Roboparty/roboto_origin/modules/Atom01_hardware/README.md

# Atom01
 Atom01 designed by roboparty
img_v3_02nq_e008615d-36c2-451e-9242-01e79ce202bg
