Roboparty/roboto_origin/modules/atom01_description/Readme.md

This is the URDF file of Atom01, a product of Roboparty.
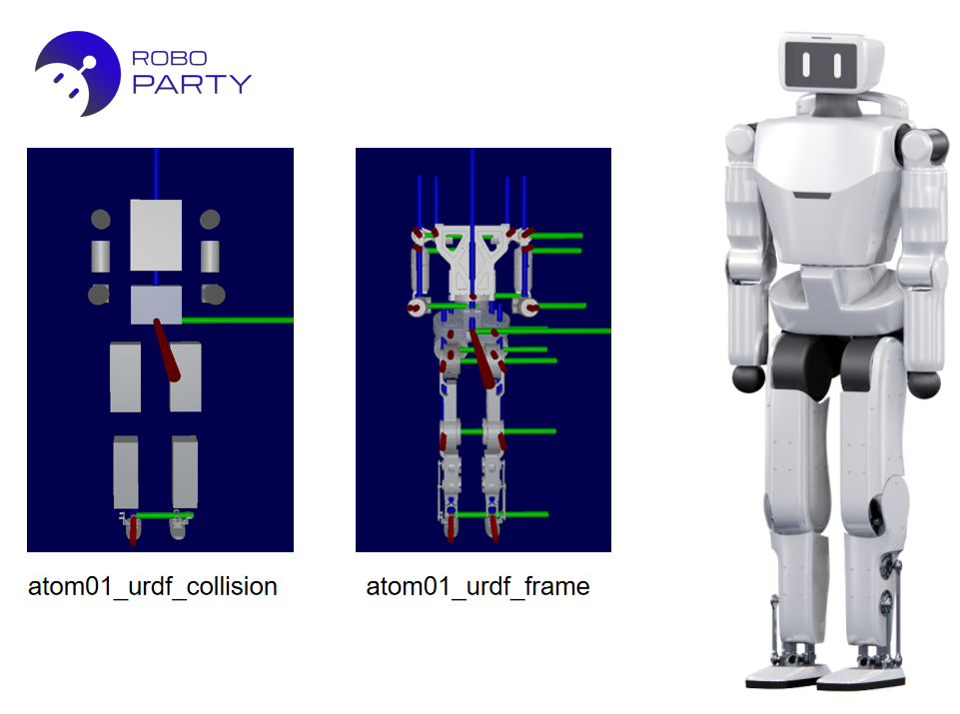
[picture p4: modules/atom01_urdf/atom01_urdf.png]
Atom01 URDF 模型
