Roboparty/roboto_origin/modules/atom01_description/terrain_assets/terrain_hfield.png

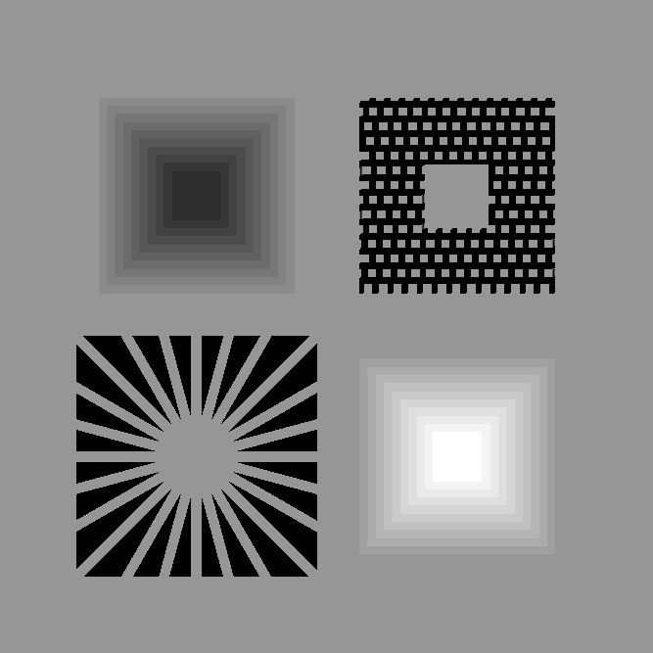
modules/atom01_description/terrain_assets/terrain_hfield.png
