Roboparty/roboto_origin/modules/Atom01_hardware/atom_id.png

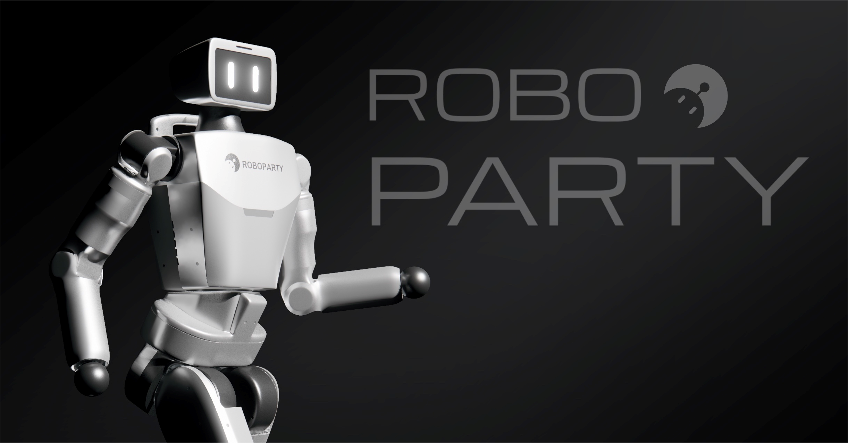
modules/Atom01_hardware/atom_id.png
