Roboparty/roboto_origin/assets/BOM_EN.md

# Internal Roboto D-BOM (English)

**DATE: | 20260105 | Edited by: Taicushier | Signature:**

**Version: | ATOM 01 v1.0.1 | Reviewed by: | Signature:**

**Product Model: | Approved by: | TOTAL:49804CNY | Signature:**

### ATOM 01 Main Frame / Structural Parts
| No. | Part No. | Item | Spec | Category | Unit | Qty | Unit Price (CNY) | Total (CNY) | Notes |
| --- | --- | --- | --- | --- | ---- | --- | --- | --- | --- |
| 1 | ATOM-01-001 | atom arm - copy (1) Atom arm(1) | 120-grit sandblasting / black anodizing | Metal Machining - CNC | pcs  | 4 | 120 | 480 | |
| 2 | ATOM-01-002 | atom arm - copy (2) Atom arm(2) | 120-grit sandblasting / black anodizing | Metal Machining - CNC | pcs  | 4 | 160 | 640 | |
| 3 | ATOM-01-003 | atom arm - copy (3) Atom arm(3) | 120-grit sandblasting / black anodizing | Metal Machining - CNC | pcs  | 4 | 110 | 440 | |
| 4 | ATOM-01-004 | atom arm - copy (4) Atom arm(4) | 120-grit sandblasting / black anodizing | Metal Machining - CNC | pcs  | 4 | 85 | 340 | |
| 5 | ATOM-01-005 | IMU Carrier Board | 120-grit sandblasting / black anodizing | Metal Machining - CNC | pcs  | 1 | 110 | 110 | |
| 6 | ATOM-01-006 | Side Plate Cross Plate | 120-grit sandblasting / black anodizing | Metal Machining - CNC | pcs  | 2 | 85 | 170 | |
| 7 | ATOM-01-007 | Inner Thigh | 120-grit sandblasting / black anodizing | Metal Machining - CNC | pcs  | 2 | 1500 | 3000 | |
| 8 | ATOM-01-008 | Battery Bottom Cover | 120-grit sandblasting / black anodizing | Metal Machining - CNC | pcs  | 1 | 420 | 420 | |
| 9 | ATOM-01-009 | Shoulder | 120-grit sandblasting / black anodizing | Metal Machining - CNC | pcs  | 2 | 160 | 320 | |
| 10  | ATOM-01-010 | Sole of Foot | 120-grit sandblasting / black anodizing | Metal Machining - CNC | pcs  | 2 | 150 | 300 | |
| 11  | ATOM-01-011 | Sole Connecting Rod | 120-grit sandblasting / black anodizing | Metal Machining - CNC | pcs  | 2 | 100 | 200 | |
| 12  | ATOM-01-012 | Ankle Roll Connector | 120-grit sandblasting / black anodizing | Metal Machining - CNC | pcs  | 4 | 35 | 140 | |
| 13  | ATOM-01-013 | Hip Joint Fixation | 120-grit sandblasting / black anodizing | Metal Machining - CNC | pcs  | 1 | 1800 | 1800 | |
| 14  | ATOM-01-014 | Hip Splint | 120-grit sandblasting / black anodizing | Metal Machining - CNC | pcs  | 2 | 350 | 700 | |
| 15  | ATOM-01-015 | Output Flange Connecting Rod | 120-grit sandblasting / black anodizing | Metal Machining - CNC | pcs  | 4 | 45 | 180 | |
| 16  | ATOM-01-016 | Universal Connector | 120-grit sandblasting / black anodizing | Metal Machining - CNC | pcs  | 4 | 360 | 1440 | |
| 17  | ATOM-01-017 | Universal Connector Reamed Flange | 120-grit sandblasting / black anodizing | Metal Machining - CNC | pcs  | 4 | 100 | 400 | |
| 18  | ATOM-01-018 | Lower Leg / Calf | 120-grit sandblasting / black anodizing | Metal Machining - CNC | pcs  | 2 | 1600 | 3200 | |
| 19  | ATOM-01-019 | Chest Rear Splint | 120-grit sandblasting / black anodizing | Metal Machining - CNC | pcs  | 1 | 350 | 350 | |
| 20  | ATOM-01-020 | Chest Front Splint | 120-grit sandblasting / black anodizing | Metal Machining - CNC | pcs  | 1 | 330 | 330 | |
| 21  | ATOM-01-021 | Limit Pin | 120-grit sandblasting / black anodizing | Metal Machining - CNC | pcs  | 8 | 15 | 120 | |
| 22  | ATOM-01-022 | Lower Leg Bearing Lock | 120-grit sandblasting / black anodizing | Metal Machining - CNC | pcs  | 4 | 50 | 200 | |
| 23  | ATOM-01-023 | Waist Support | 120-grit sandblasting / black anodizing | Metal Machining - CNC | pcs  | 1 | 150 | 150 | |
| 24  | ATOM-01-024 | Long Connecting Rod | 120-grit sandblasting / black anodizing | Metal Machining - CNC | pcs  | 2 | 70 | 140 | |
| 25  | ATOM-01-025 | Short Connecting Rod | Sandblasting only | Metal Machining - CNC | pcs  | 2 | 50 | 100 | |
| 26  | ATOM-01-026 | Rubber Sole | | 3D Printed Part | pcs  | 2 | | | |
| | | | | | | **Total parts:** | **70** | **Subtotal:** | **15670** |  |

### ATOM 01 Battery Assembly
| No. | Part No. | Item | Spec | Category | Unit | Qty | Unit Price (CNY) | Total (CNY) | Notes |
| --- | --- | --- | --- | --- | ---- | --- | --- | --- | --- |
| 27  | ATOM-01-027 | 48V 15Ah Li-ion pack  | 140*140*115mm (Fu Xiao Er) | Lithium-ion battery | pcs  | 1 | 528 | 528 | https://detail.tmall.com/item.htm?id=764331116646&skuId=5258779996800&spm=a21m98.27004841 |
| 28  | ATOM-01-028 | Emergency stop relay  | Lanbo M3 oxidized head - no light | Mechanical - purchased standard part (no standard No.) | pcs  | 1 | 31.5 | 31.5 | https://item.taobao.com/item.htm?id=677801301134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 |
| 29  | ATOM-01-029 | Aviation plug charger | WEIPU SF1212/S2 | Mechanical - purchased standard part (no standard No.) | pcs  | 1 | 12.43 | 12.43 | https://item.taobao.com/item.htm?id=959402988414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 |

### ATOM 01 Calibration Tools
| No. | Part No. | Item | Spec | Category | Unit | Qty | Unit Price (CNY) | Total (CNY) | Notes |
| --- | --- | --- | --- | --- | ---- | --- | --- | --- | ----- |
| 30  | ATOM-01-030 | ATOM 01 calibration part | 3D printed / lying calibration / arms vertical | 3D Printed Part | | | | | |

### ATOM 01 Sensors
| No. | Part No. | Item | Spec | Category | Unit | Qty | Unit Price (CNY) | Total (CNY) | Notes |
| --- | --- | --- | ---- | --- | ---- | --- | --- | --- | --- |
| 33  | ATOM-01-033 | Chaohe HI13 M0-USB | | Electrical/Electronics - purchased standard part (no standard No.) | pcs  | 1 | 350 | 350 | https://detail.tmall.com/item.htm?id=728807358097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 |

### ATOM 01 Actuators
| No. | Part No. | Item | Spec | Category | Unit | Qty | Unit Price (CNY) | Total (CNY) | Notes |
| --- | --- | --- | ---- | --- | ---- | --- | --- | --- | --- |
| 35  | ATOM-01-035 | DM 4340P (48V) | - | Electrical/Electronics - purchased standard part (no standard No.) | pcs  | 14  | 949 | 13286 | https://item.taobao.com/item.htm?id=852485614821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 |
| 36  | ATOM-01-036 | DM 10010L | - | Electrical/Electronics - purchased standard part (no standard No.) | pcs  | 9 | 1989 | 17901 | https://item.taobao.com/item.htm?id=947247019784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 |

### ATOM 01 Electronic Components
| No. | Part No. | Item | Spec | Category | Unit | Qty | Unit Price (CNY) | Total (CNY) | Notes |
| --- | --- | --- | --- | --- | ---- | --- | --- | --- | --- |
| 37  | ATOM-01-037 | RK3588 / Orange Pi 5 PLUS | 4G / SBC + PSU + cooling case | Electrical/Electronics - purchased standard part (no standard No.) | pcs  | 1 | 690 | 690 | https://item.taobao.com/item.htm?id=718906164843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 |
| 38  | ATOM-01-038 | USB hub | - | Electrical/Electronics - purchased standard part (no standard No.) | pcs  | 1 | 16 | 16 | https://detail.tmall.com/item.htm?id=740809316054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 |
| 39  | ATOM-01-039 | USB-to-CAN | - | Electrical/Electronics - purchased standard part (no standard No.) | pcs  | 4 | 46 | 164 | https://item.taobao.com/item.htm?id=711974380607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 |
| 40  | ATOM-01-040 | 48V to 5V DC-DC module | - | Electrical/Electronics - purchased standard part (no standard No.) | pcs  | 1 | 28 | 28 | https://detail.tmall.com/item.htm?id=922075339624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 |
| 41  | ATOM-01-041 | Power distribution center board | - | Electrical/Electronics - purchased standard part (no standard No.) | pcs  | 1 | 54 | 54 | https://e.tb.cn/h.7RRC0YOBb9c6XA9?tk=zXubUYhrKtR |
| 42  | ATOM-01-042 | CAN adapter board | - | Electrical/Electronics - purchased standard part (no standard No.) | pcs  | 4 | 14 | 56 | https://item.taobao.com/item.htm?id=966115876867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 |
| 45  | ATOM-01-045 | wire01 - 40cm | 4340P to 10010L | Electrical/Electronics - purchased standard part (no standard No.) | pcs  | 4 | 400 | 400 | |
| 46  | ATOM-01-046 | wire01 - 20cm | 4340P to 10010L | Electrical/Electronics - purchased standard part (no standard No.) | pcs  | 4 | | | |
| 47  | ATOM-01-047 | wire01 - 10cm | 4340P to 10010L | Electrical/Electronics - purchased standard part (no standard No.) | pcs  | 2 | | | |
| 48  | ATOM-01-048 | wire02 - 40cm | 4340P to 4340P | Electrical/Electronics - purchased standard part (no standard No.) | pcs  | 2 | | | |
| 49  | ATOM-01-049 | wire02 - 20cm | 4340P to 4340P | Electrical/Electronics - purchased standard part (no standard No.) | pcs  | 8 | | | |
| 50  | ATOM-01-050 | wire02 - 10cm | 4340P to 4340P | Electrical/Electronics - purchased standard part (no standard No.) | pcs  | 2 | | | |
| 51  | ATOM-01-051 | wire03 - 40cm | 10010L to 10010L | Electrical/Electronics - purchased standard part (no standard No.) | pcs  | 10  | | | |
| 52  | ATOM-01-052 | wire03 - 20cm | 10010L to 10010L | Electrical/Electronics - purchased standard part (no standard No.) | pcs  | 4 | | | |

### ATOM 01 Mechanical Hardware
| No. | Part No. | Item | Spec | Category | Unit | Qty | Unit Price (CNY) | Total (CNY)  | Notes |
| --- | --- | --- | --- | --- | ---- | --- | --- | --- | ----- |
| 53  | ATOM-01-053 | Hex socket head cap screw M3×6 | GB/T 70.1-2000 | Mechanical - purchased standard part (no standard No.) | pcs  | 20  | 50 | 50 | |
| 54  | ATOM-01-054 | Hex socket head cap screw M3×8 | GB/T 70.1-2000 | Mechanical - purchased standard part (no standard No.) | pcs  | 50  | | | |
| 55  | ATOM-01-055 | Hex socket head cap screw M3×10 | GB/T 70.1-2000 | Mechanical - purchased standard part (no standard No.) | pcs  | 70  | | | |
| 56  | ATOM-01-056 | Hex socket head cap screw M3×12 | GB/T 70.1-2000 | Mechanical - purchased standard part (no standard No.) | pcs  | 30  | | | |
| 57  | ATOM-01-057 | Hex socket head cap screw M3×16 | GB/T 70.1-2000 | Mechanical - purchased standard part (no standard No.) | pcs  | 100 | | | |
| 58  | ATOM-01-058 | Hex socket head cap screw M4×8 | GB/T 70.1-2000 | Mechanical - purchased standard part (no standard No.) | pcs  | 160 | | | |
| 59  | ATOM-01-059 | Hex socket head cap screw M4×10 | GB/T 70.1-2000 | Mechanical - purchased standard part (no standard No.) | pcs  | 70  | | | |
| 60  | ATOM-01-060 | Hex socket head cap screw M4×12 | GB/T 70.1-2000 | Mechanical - purchased standard part (no standard No.) | pcs  | 60  | | | |
| 61  | ATOM-01-061 | Hex socket head cap screw M4×16 | GB/T 70.1-2000 | Mechanical - purchased standard part (no standard No.) | pcs  | 30  | | | |
| 62  | ATOM-01-062 | Hex socket head cap screw M5×10 | GB/T 70.1-2000 | Mechanical - purchased standard part (no standard No.) | pcs  | 70  | | | |
| 63  | ATOM-01-063 | Hex countersunk head screw M6×15 | GB/T 70.3-2008 | Mechanical - purchased standard part (no standard No.) | pcs  | 2 | | | |
| 64  | ATOM-01-064 | Hex nut M6 | GB/T 6170-2015 | Mechanical - purchased standard part (no standard No.) | pcs  | 2 | | | |
| 65  | ATOM-01-065 | Lifting eye bolt M3 | GB/T 825-1988  | Mechanical - purchased standard part (no standard No.) | pcs  | 4 | | | |
| 66  | ATOM-01-066 | Deep groove ball bearing 130*165*18 | GB/T 276-2013  | Mechanical - purchased standard part (no standard No.) | pcs  | 1 | 506.6 | 506.6 | |
| 67  | ATOM-01-067 | Spherical plain bearing (G-series) 8 | GB/T 9161-2001 | Mechanical - purchased standard part (no standard No.) | pcs  | 8 | | | |
| 68  | ATOM-01-068 | Thrust needle roller and cage assembly AXK6085 | GB/T 4605-2003 | Mechanical - purchased standard part (no standard No.) | pcs  | 9 | | | |
| | | | | | | | **Total:** | **49743.53** | |
