Roboparty/roboto_origin/modules/Atom01_hardware/atom01_mechnaic/atom_wire/wire/Wire01(xt30_2+2-xt30+gh1.25)/SW/XT30.SLDASM

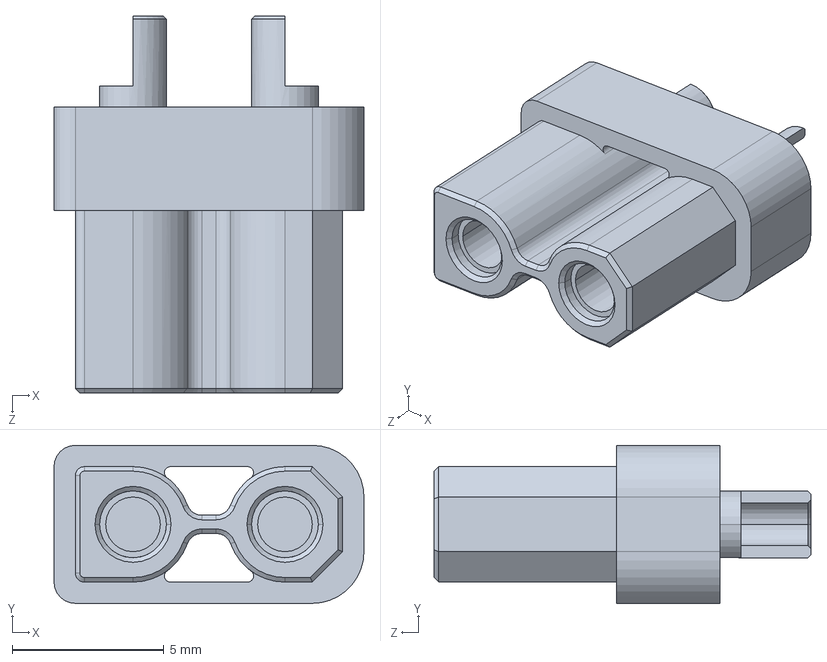
[picture p7: CAD file, 2025-12-31]
modules/Atom01_hardware/atom01_mechnaic/atom_wire/wire/Wire01(xt30_2+2-xt30+gh1.25)/SW/XT30.SLDASM
10.2 x 5.21 x 12.4 mm
