Roboparty/roboto_origin/modules/Atom01_hardware/atom01_mechnaic/Atom01_battery/battery.SLDASM

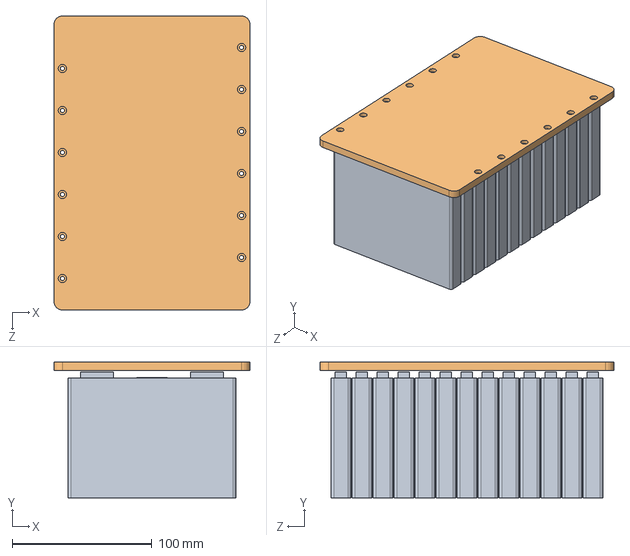
[picture p8: CAD file, 2025-12-31]
modules/Atom01_hardware/atom01_mechnaic/Atom01_battery/battery.SLDASM
140.0 x 97.0 x 210.0 mm
CATL_6.2Ah_battery x 13
battery_controller_top
