Roboparty/roboto_origin/modules/Atom01_hardware/atom01_mechnaic/atom_wire/wire/Wire01(xt30_2+2-xt30+gh1.25)/SW/Assem1.SLDASM

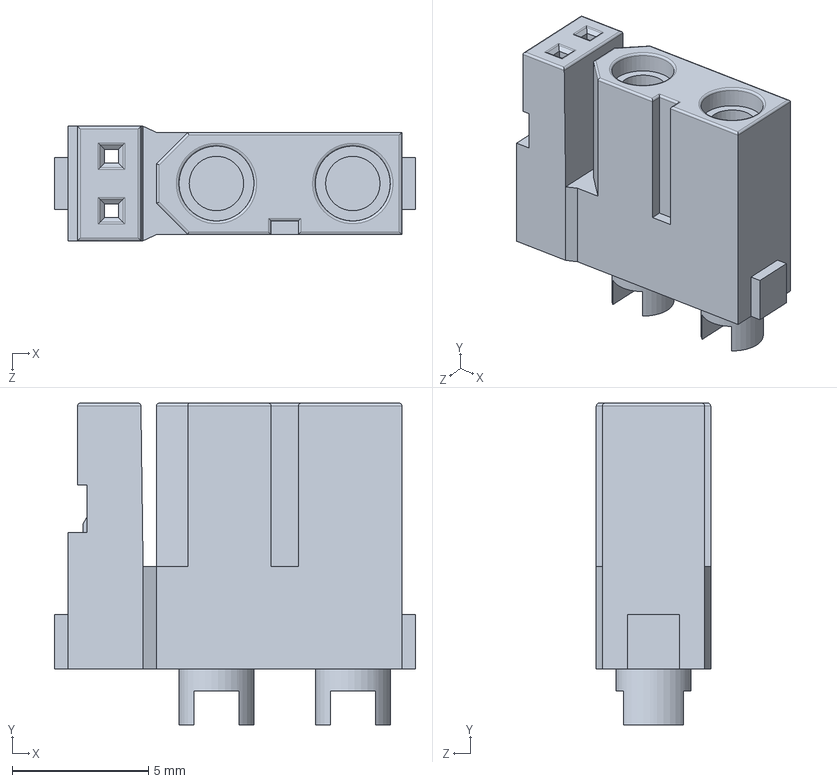
[picture p9: CAD file, 2025-12-31]
modules/Atom01_hardware/atom01_mechnaic/atom_wire/wire/Wire01(xt30_2+2-xt30+gh1.25)/SW/Assem1.SLDASM
13.2 x 11.8 x 4.20 mm
