Roboparty/roboto_origin/modules/Atom01_hardware/atom01_mechnaic/atom_wire/wire/Wire03(xt30+gh1.25-xt30+gh1.25)/SW/wire.SLDASM

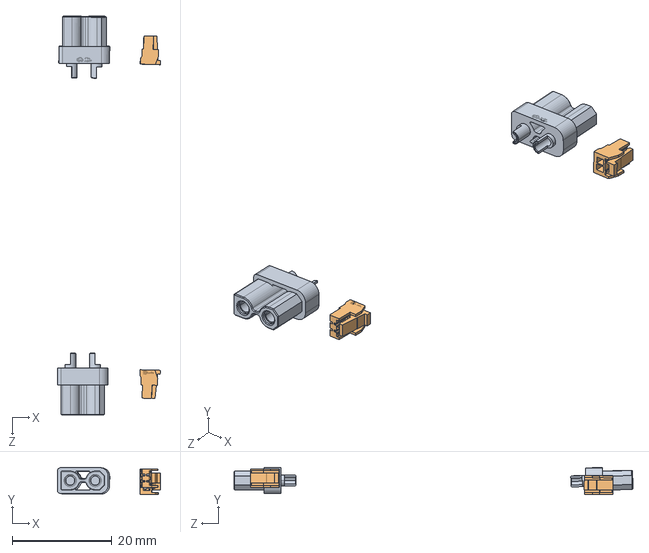
[picture p10: CAD file, 2025-12-31]
modules/Atom01_hardware/atom01_mechnaic/atom_wire/wire/Wire03(xt30+gh1.25-xt30+gh1.25)/SW/wire.SLDASM
20.7 x 5.41 x 80.0 mm
CONN-TH_XT30U-F~CONN-TH_XT30U-F~z1Un x 2
GH1.25 x 2
