Roboparty/roboto_origin/modules/Atom01_hardware/atom01_mechnaic/atom_wire/wire/Wire02(xt30_2+2-xt30_2+2)/wire02.SLDASM

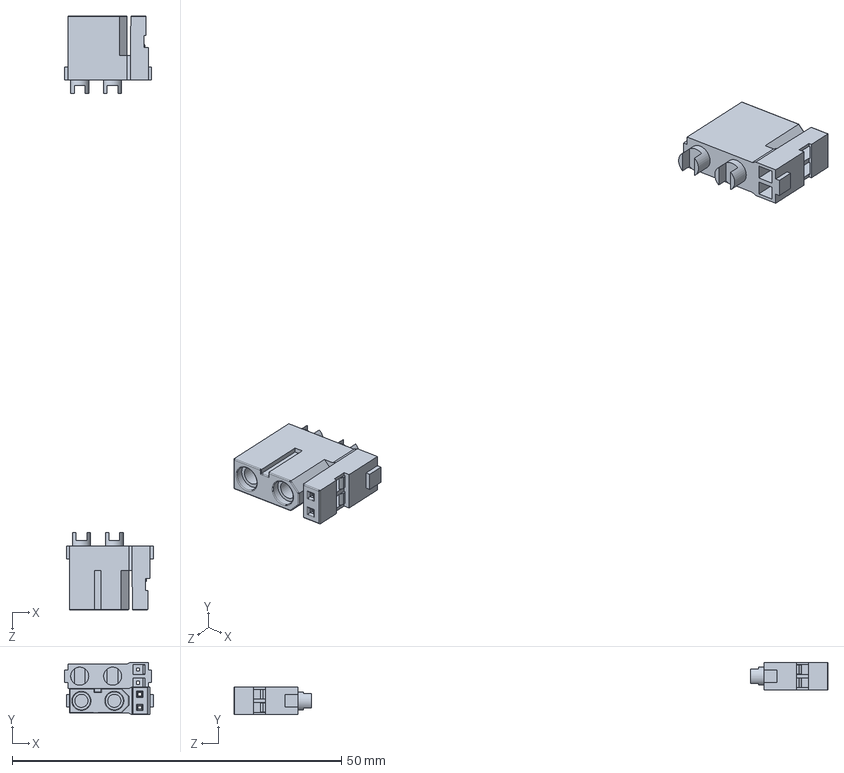
[picture p11: CAD file, 2025-12-31]
modules/Atom01_hardware/atom01_mechnaic/atom_wire/wire/Wire02(xt30_2+2-xt30_2+2)/wire02.SLDASM
13.5 x 7.95 x 90.2 mm
XT30(2+2) x 2
