Roboparty/roboto_origin/modules/Atom01_hardware/atom01_mechnaic/atom_wire/wire/Wire01(xt30_2+2-xt30+gh1.25)/SW/wire.SLDASM

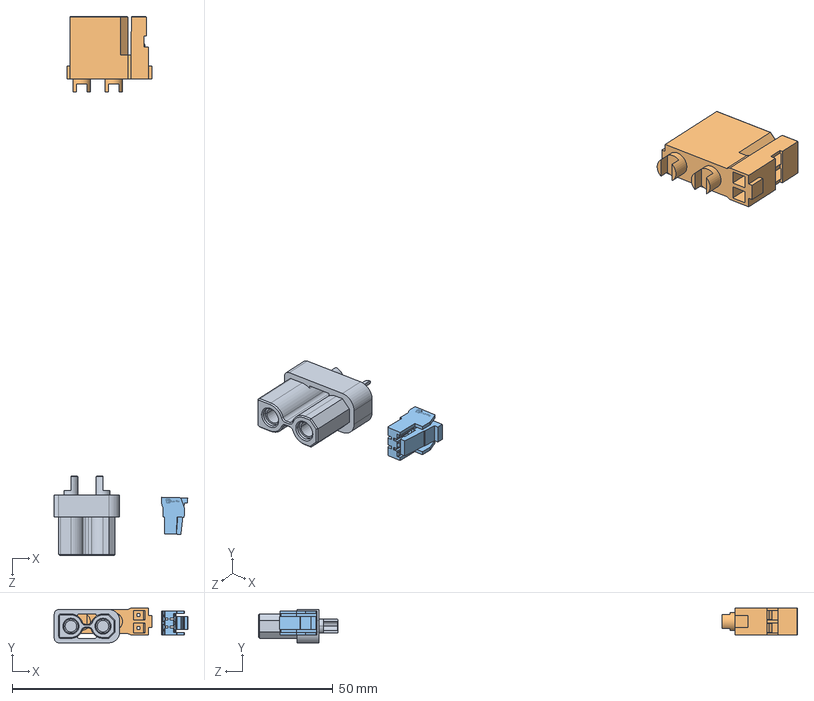
[picture p12: CAD file, 2025-12-31]
modules/Atom01_hardware/atom01_mechnaic/atom_wire/wire/Wire01(xt30_2+2-xt30+gh1.25)/SW/wire.SLDASM
20.8 x 5.43 x 84.0 mm
CONN-TH_XT30U-F~CONN-TH_XT30U-F~z1Un
XT30(2+2)
GH1.25
