Roboparty/roboto_origin/modules/atom01_description/meshes/left_elbow_yaw_link.STL

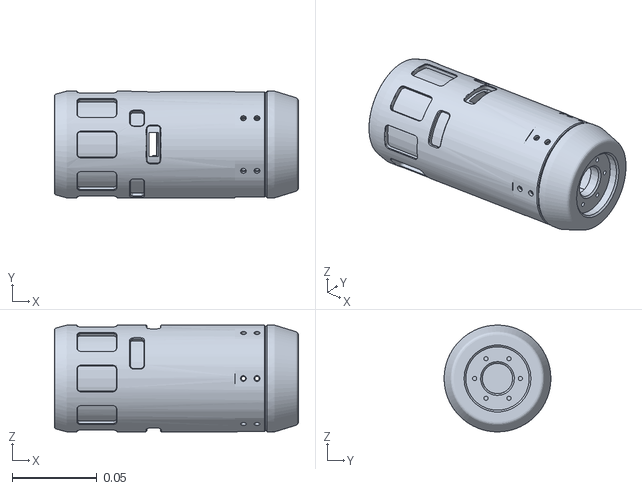
[picture p13: CAD file, 2025-12-31]
modules/atom01_description/meshes/left_elbow_yaw_link.STL
0.144 x 0.063 x 0.063
