Roboparty/roboto_origin/modules/Atom01_hardware/atom01_mechnaic/atom-bom/SW模型/GB╱T 70.1-2008[内六角圆柱头螺钉M3×10].step

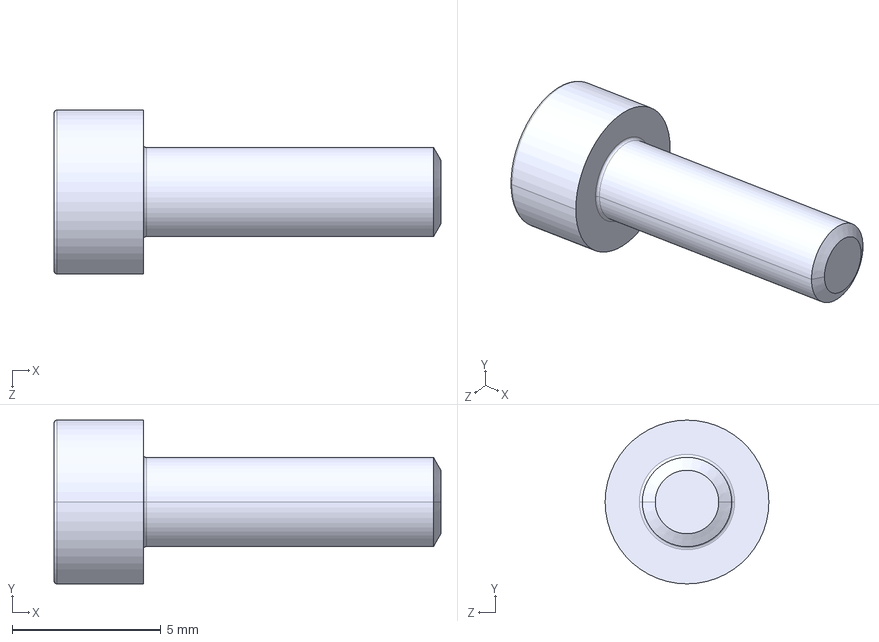
[picture p14: CAD file, 2025-12-31]
modules/Atom01_hardware/atom01_mechnaic/atom-bom/SW模型/GB╱T 70.1-2008[内六角圆柱头螺钉M3×10].step
13.0 x 5.50 x 5.50 mm
