Roboparty/roboto_origin/modules/Atom01_hardware/atom01_mechnaic/atom-bom/SW模型/外壳修改部件(1)/外壳修改部件/大腿根部结构开孔.stp

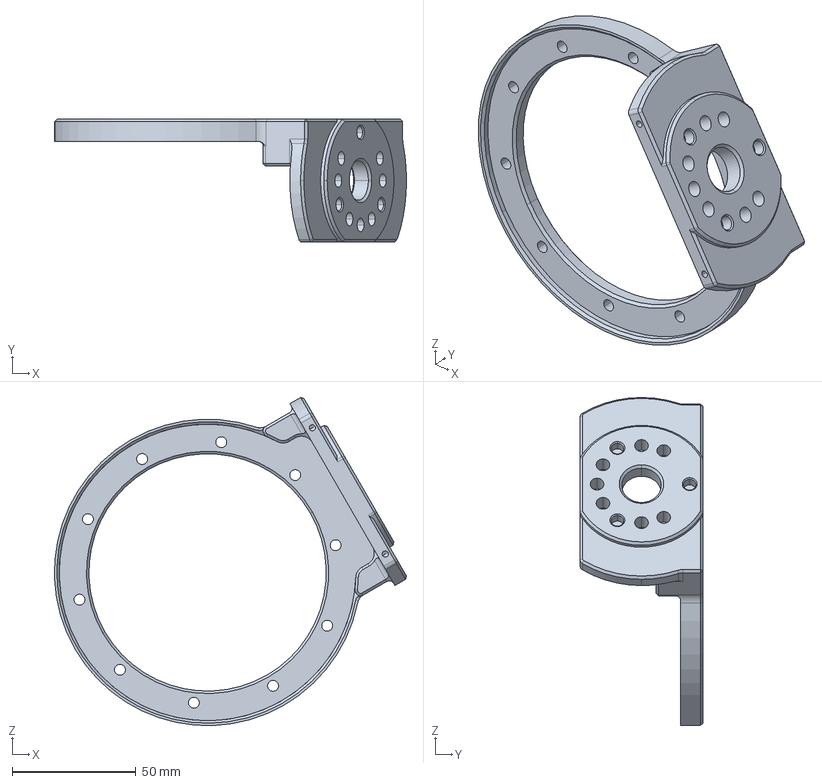
[picture p15: CAD file, 2025-12-31]
modules/Atom01_hardware/atom01_mechnaic/atom-bom/SW模型/外壳修改部件(1)/外壳修改部件/大腿根部结构开孔.stp
142.5 x 49.7 x 132.8 mm
