Roboparty/roboto_origin/modules/Atom01_hardware/atom01_mechnaic/atom-bom/图纸&STEP模型/脚踝横滚连接件.STEP

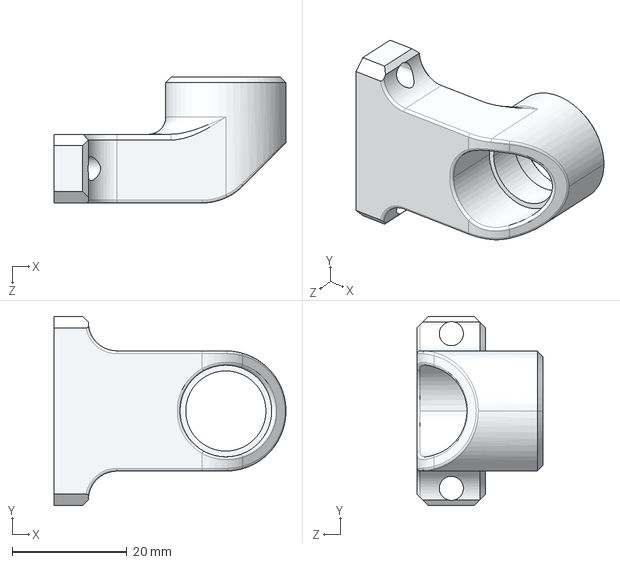
[picture p16: CAD file, 2025-12-31]
modules/Atom01_hardware/atom01_mechnaic/atom-bom/图纸&STEP模型/脚踝横滚连接件.STEP
40.5 x 33.0 x 22.0 mm
