Roboparty/roboto_origin/modules/Atom01_hardware/atom01_mechnaic/atom-id/头颈.stp

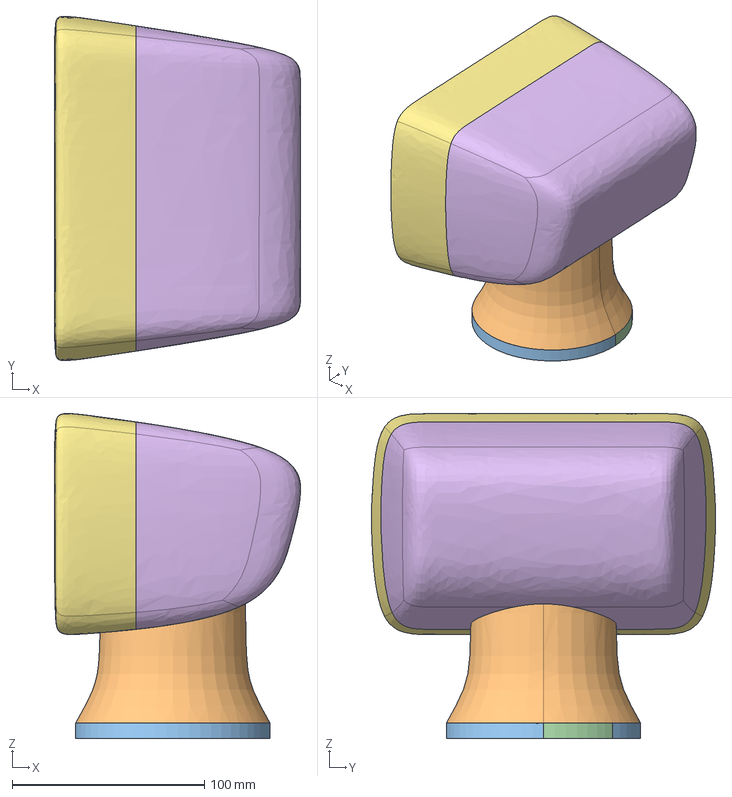
[picture p17: CAD file, 2025-12-31]
modules/Atom01_hardware/atom01_mechnaic/atom-id/头颈.stp
128.2 x 179.2 x 169.2 mm
