Roboparty/roboto_origin/modules/Atom01_hardware/atom01_mechnaic/Atom01_battery/battery_controller.STEP

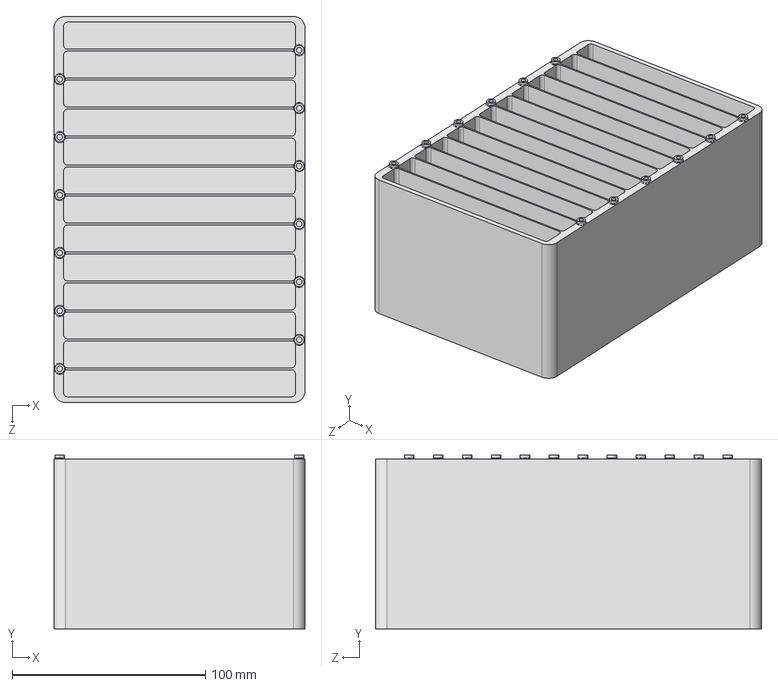
[picture p18: CAD file, 2025-12-31]
modules/Atom01_hardware/atom01_mechnaic/Atom01_battery/battery_controller.STEP
130.0 x 90.0 x 200.0 mm
