Roboparty/roboto_origin/modules/Atom01_hardware/atom01_mechnaic/atom_wire/Step/WAFER-GH1.25-2PJK.STEP

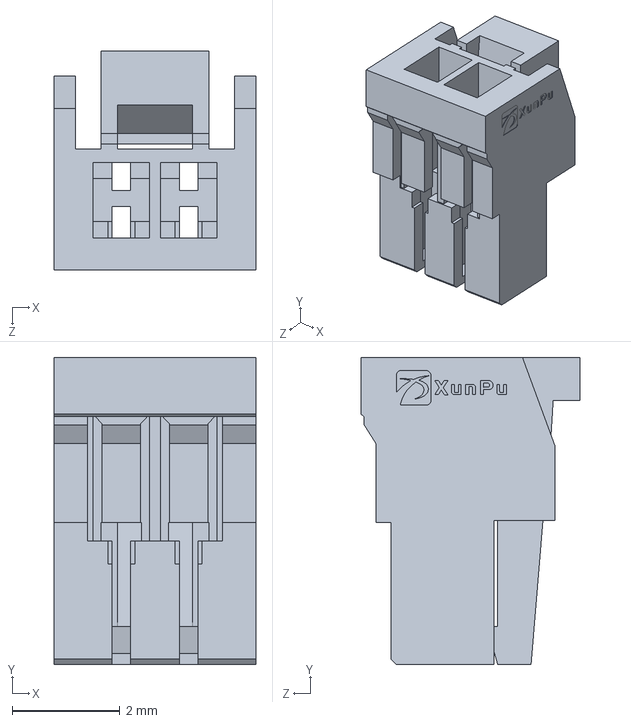
[picture p19: CAD file, 2025-12-31]
modules/Atom01_hardware/atom01_mechnaic/atom_wire/Step/WAFER-GH1.25-2PJK.STEP
3.75 x 5.70 x 4.07 mm
