Roboparty/roboto_origin/modules/Atom01_hardware/atom01_pcb/3D_PCB2_2025-05-14.step

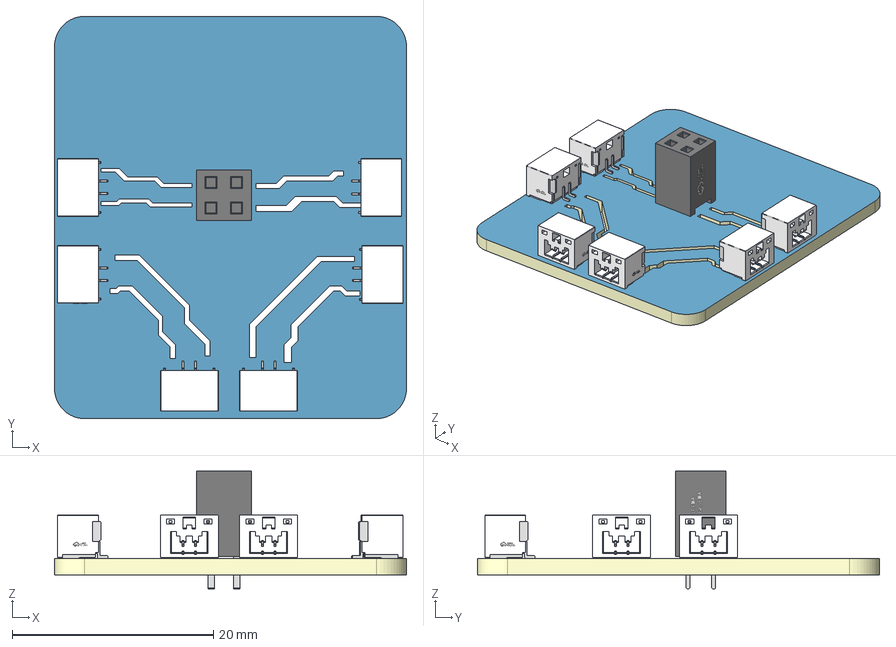
[picture p20: CAD file, 2025-12-31]
modules/Atom01_hardware/atom01_pcb/3D_PCB2_2025-05-14.step
35.0 x 40.0 x 11.7 mm
TopTrack
BottomTrack
Board
