Roboparty/roboto_origin/modules/Atom01_hardware/atom01_mechnaic/atom-bom/SW模型/外壳修改部件(1)/外壳修改部件/腰部下册.stp

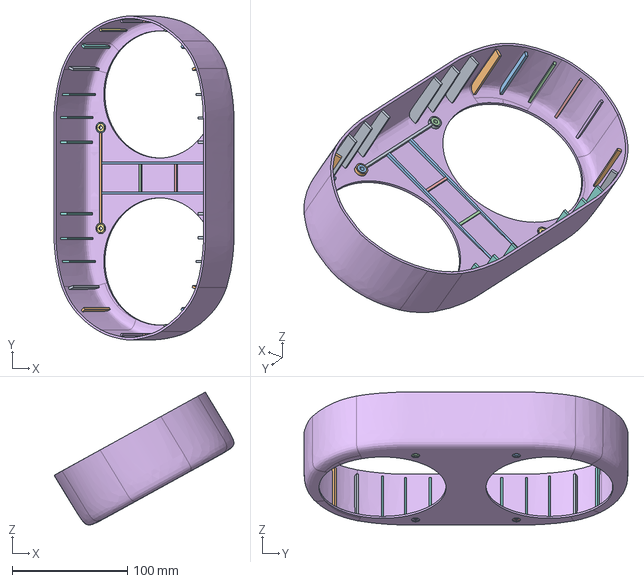
[picture p22: CAD file, 2025-12-31]
modules/Atom01_hardware/atom01_mechnaic/atom-bom/SW模型/外壳修改部件(1)/外壳修改部件/腰部下册.stp
156.1 x 281.2 x 115.4 mm
