Roboparty/roboto_origin/modules/Atom01_hardware/atom01_mechnaic/atom-bom/SW模型/平头M5x10螺丝.SLDPRT

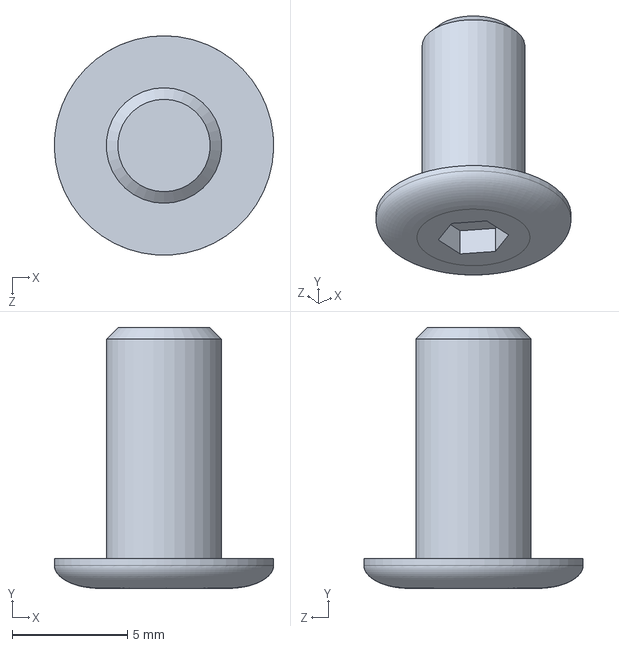
[picture p23: CAD file, 2025-12-31]
modules/Atom01_hardware/atom01_mechnaic/atom-bom/SW模型/平头M5x10螺丝.SLDPRT
9.49 x 11.3 x 9.50 mm
