Roboparty/roboto_origin/modules/Atom01_hardware/atom01_mechnaic/atom-bom/图纸&STEP模型/长连杆.STEP

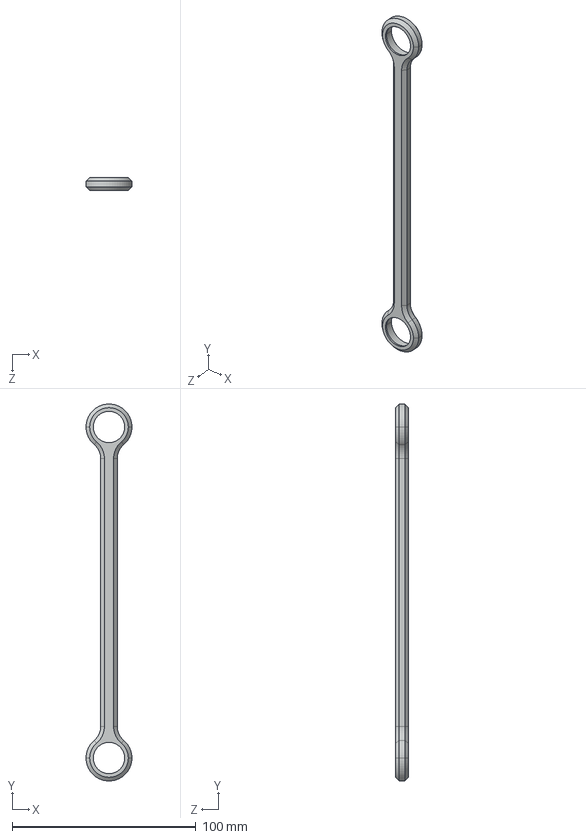
[picture p24: CAD file, 2025-12-31]
modules/Atom01_hardware/atom01_mechnaic/atom-bom/图纸&STEP模型/长连杆.STEP
25.0 x 205.0 x 7.00 mm
