Roboparty/roboto_origin/modules/Atom01_hardware/atom01_mechnaic/atom-id/胸腔背部提手.stp

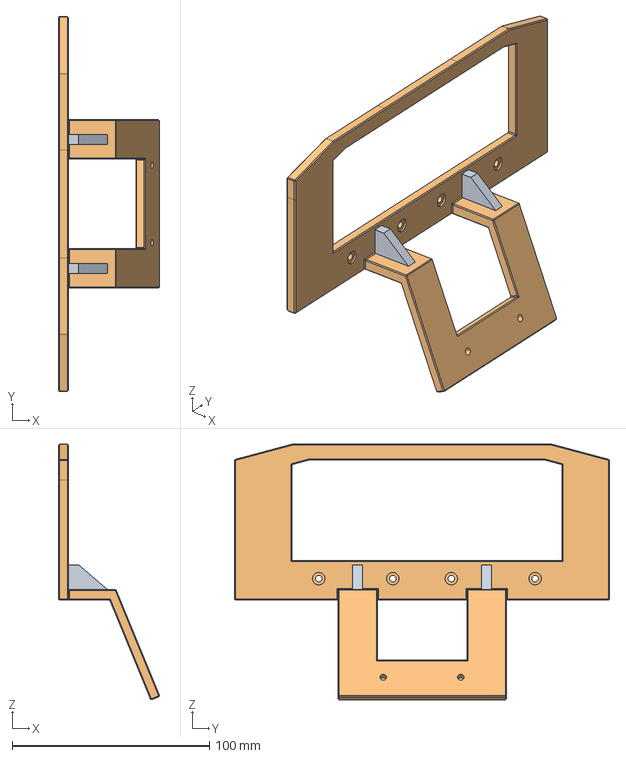
[picture p25: CAD file, 2025-12-31]
modules/Atom01_hardware/atom01_mechnaic/atom-id/胸腔背部提手.stp
51.2 x 190.0 x 129.5 mm
