Roboparty/roboto_origin/modules/Atom01_hardware/atom01_mechnaic/atom-packngo/atom手臂 - 副本 (4).SLDPRT

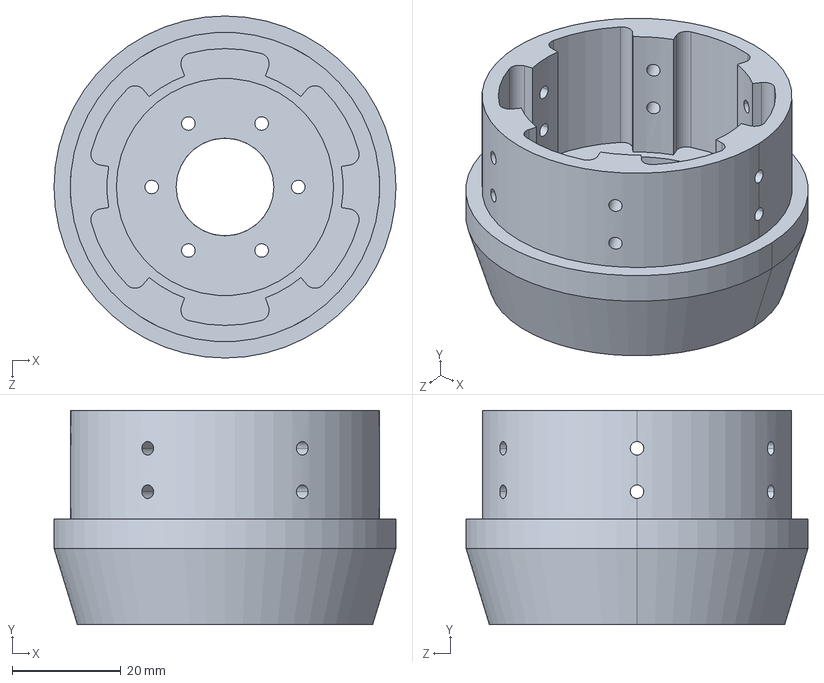
[picture p26: CAD file, 2025-12-31]
modules/Atom01_hardware/atom01_mechnaic/atom-packngo/atom手臂 - 副本 (4).SLDPRT
63.0 x 39.5 x 63.0 mm
