Roboparty/roboto_origin/modules/Atom01_hardware/atom01_mechnaic/Atom01_battery/battery_controller_top.SLDPRT

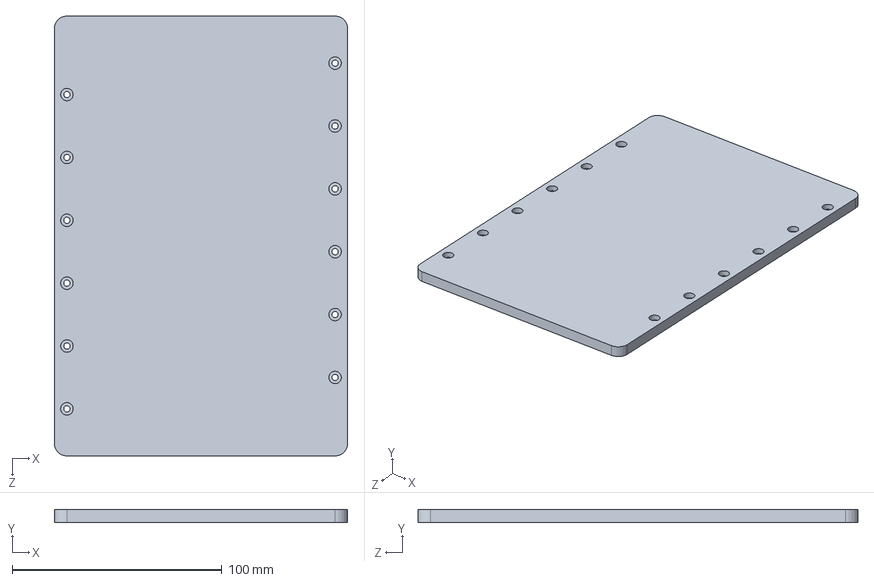
[picture p27: CAD file, 2025-12-31]
modules/Atom01_hardware/atom01_mechnaic/Atom01_battery/battery_controller_top.SLDPRT
140.0 x 6.00 x 210.0 mm
