Roboparty/roboto_origin/modules/atom01_description/meshes/base_link.STL

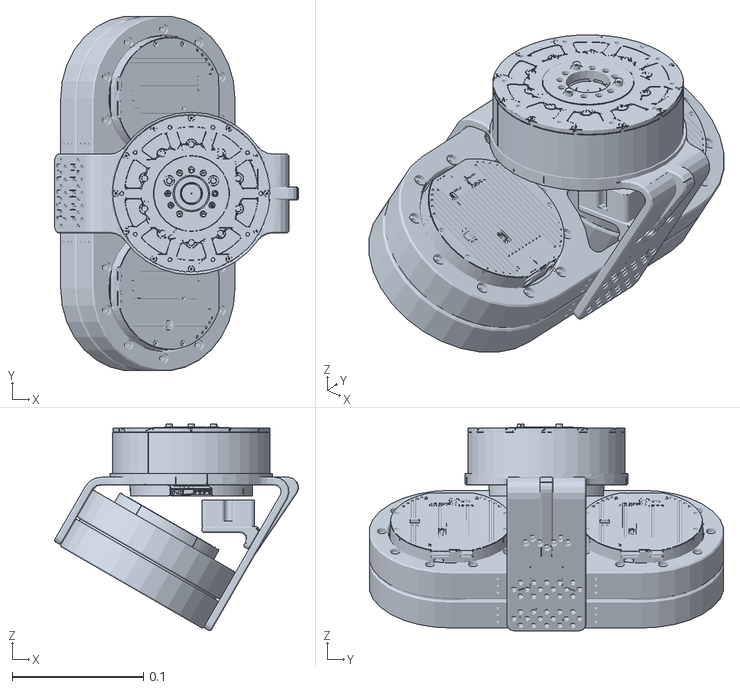
[picture p28: CAD file, 2025-12-31]
modules/atom01_description/meshes/base_link.STL
0.186 x 0.27 x 0.158
