Roboparty/roboto_origin/modules/Atom01_hardware/atom01_mechnaic/atom-bom/SW模型/外壳修改部件(1)/外壳修改部件/胸腔肩部.stp

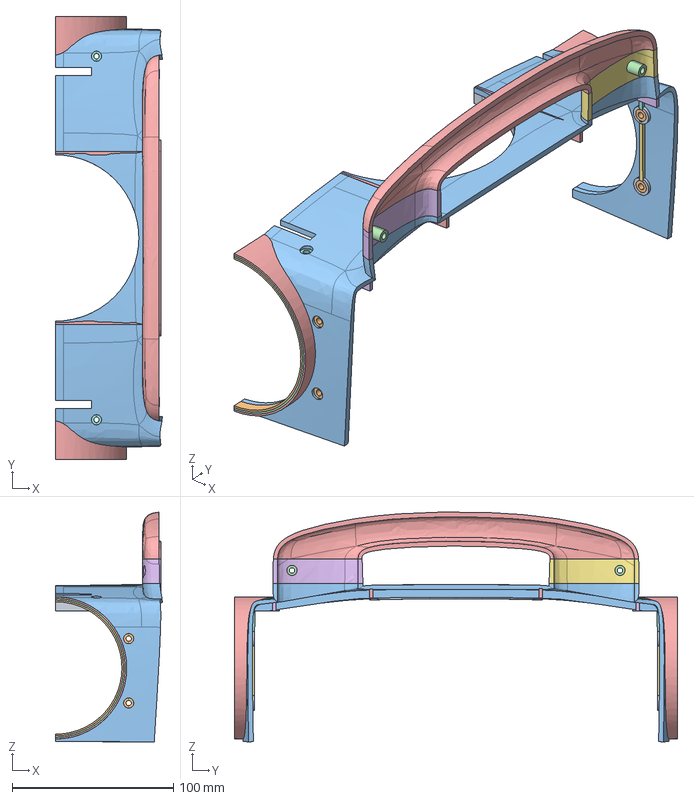
[picture p29: CAD file, 2025-12-31]
modules/Atom01_hardware/atom01_mechnaic/atom-bom/SW模型/外壳修改部件(1)/外壳修改部件/胸腔肩部.stp
66.2 x 275.1 x 142.7 mm
