Roboparty/roboto_origin/modules/Atom01_hardware/atom01_mechnaic/atom-bom/SW模型/长连杆.SLDPRT

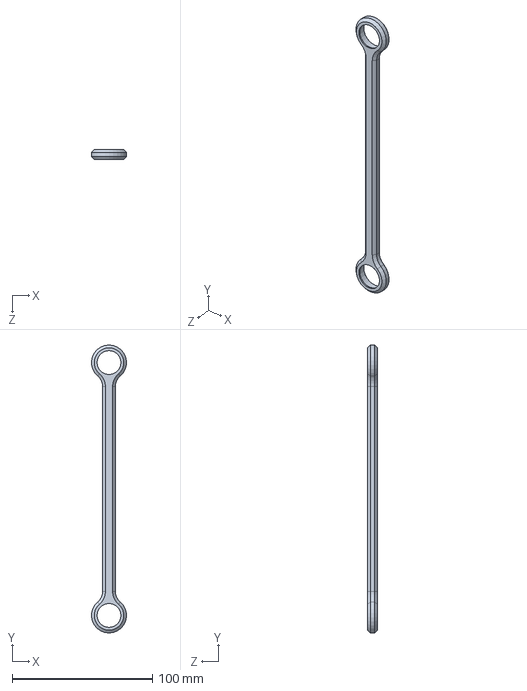
[picture p30: CAD file, 2025-12-31]
modules/Atom01_hardware/atom01_mechnaic/atom-bom/SW模型/长连杆.SLDPRT
24.9 x 205.0 x 7.00 mm
