Roboparty/roboto_origin/modules/Atom01_hardware/atom01_mechnaic/atom-bom/图纸&STEP模型/髋关节固定.STEP

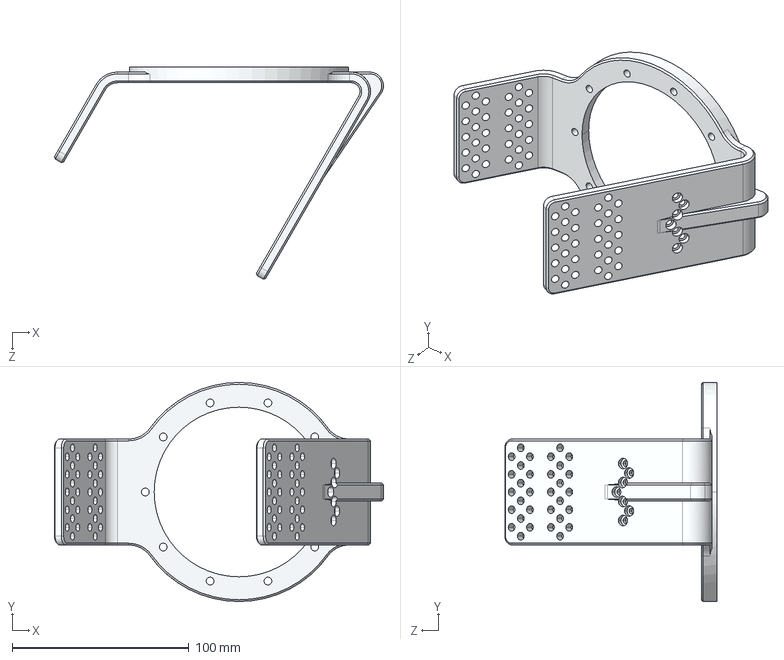
[picture p31: CAD file, 2025-12-31]
modules/Atom01_hardware/atom01_mechnaic/atom-bom/图纸&STEP模型/髋关节固定.STEP
186.2 x 124.0 x 120.2 mm
