Roboparty/roboto_origin/modules/Atom01_hardware/atom01_mechnaic/atom-id/大臂根部后侧.stp

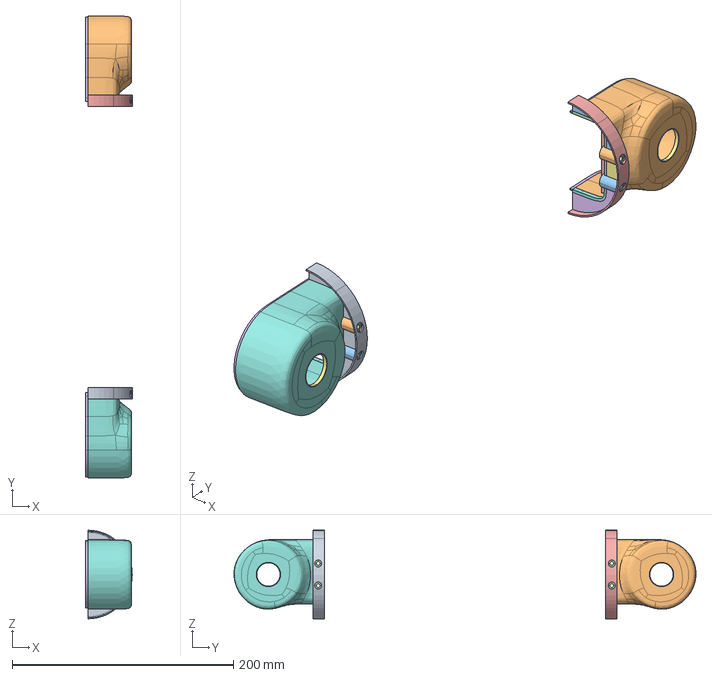
[picture p32: CAD file, 2025-12-31]
modules/Atom01_hardware/atom01_mechnaic/atom-id/大臂根部后侧.stp
42.1 x 417.7 x 80.2 mm
