Roboparty/roboto_origin/modules/Atom01_hardware/atom01_mechnaic/atom_wire/Step/xt30-F.step

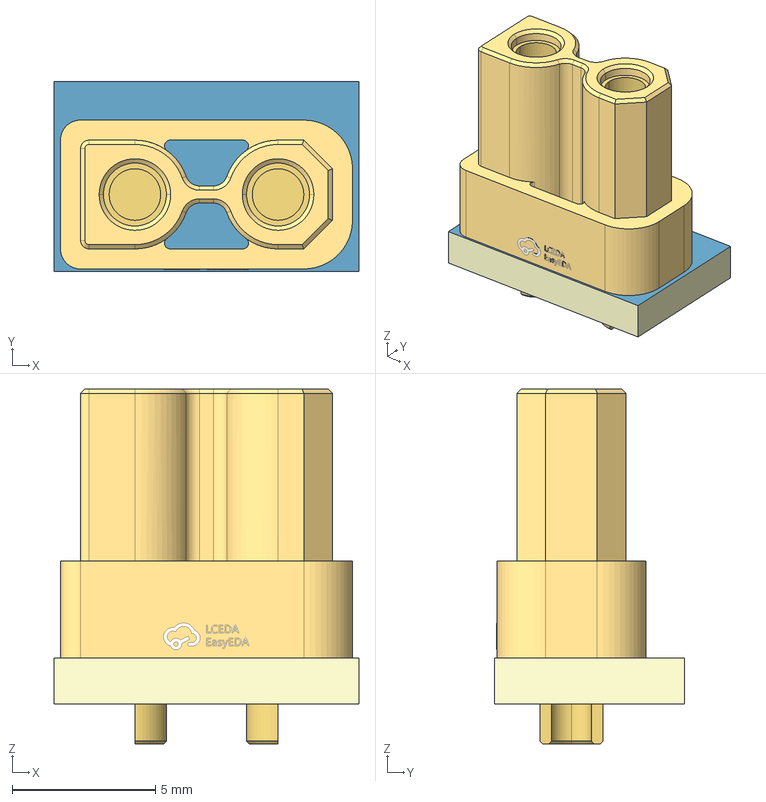
[picture p33: CAD file, 2025-12-31]
modules/Atom01_hardware/atom01_mechnaic/atom_wire/Step/xt30-F.step
10.6 x 6.65 x 12.4 mm
Board~z1Un
TopCopper~z1Un
BottomCopper~z1Un
TopFpcStiffener~z1Un
BottomFpcStiffener~z1Un
CONN-TH_XT30U-F~CONN-TH_XT30U-F~z1Un
