Roboparty/roboto_origin/modules/atom01_description/meshes/right_ankle_roll_link.STL

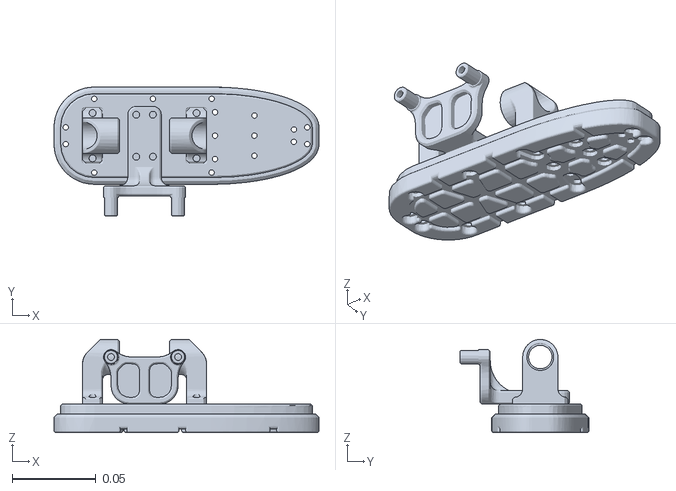
[picture p34: CAD file, 2025-12-31]
modules/atom01_description/meshes/right_ankle_roll_link.STL
0.158 x 0.0769 x 0.0555
