Roboparty/roboto_origin/modules/Atom01_hardware/atom01_mechnaic/atom-bom/SW模型/胸腔前后夹板.SLDPRT

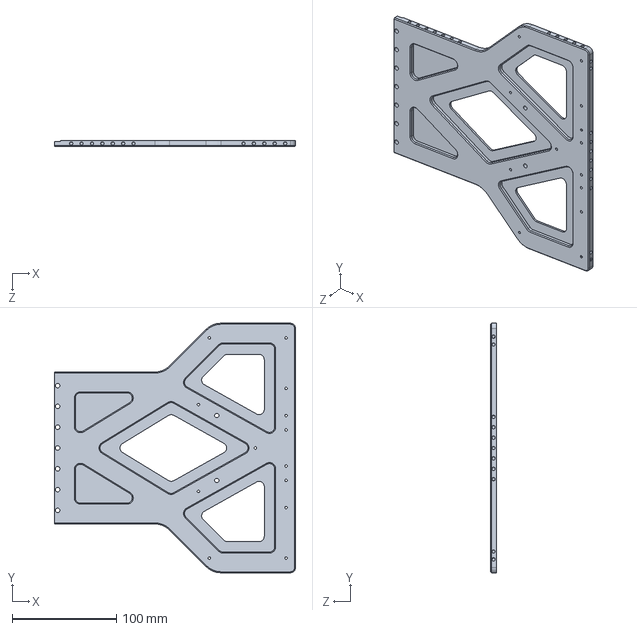
[picture p35: CAD file, 2025-12-31]
modules/Atom01_hardware/atom01_mechnaic/atom-bom/SW模型/胸腔前后夹板.SLDPRT
231.7 x 240.0 x 6.00 mm
