Roboparty/roboto_origin/modules/Atom01_hardware/atom01_mechnaic/atom-bom/图纸&STEP模型/大腿内侧.STEP

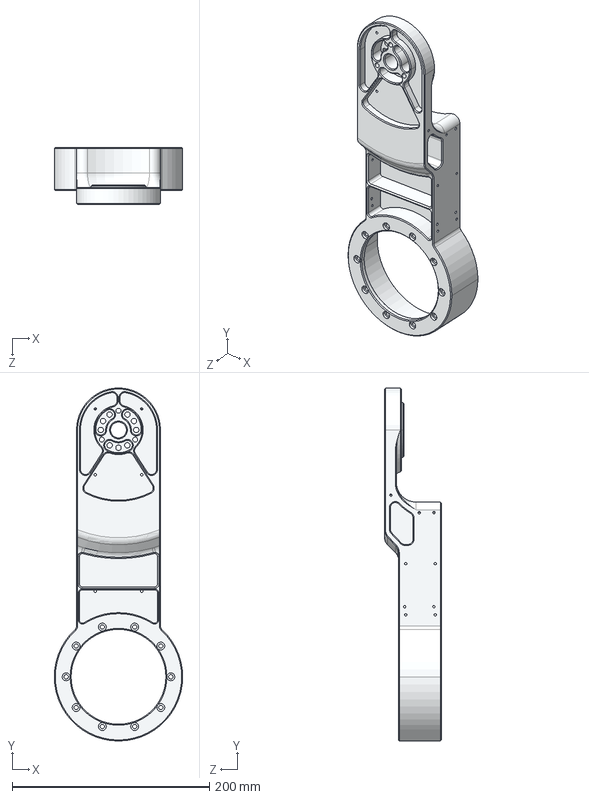
[picture p36: CAD file, 2025-12-31]
modules/Atom01_hardware/atom01_mechnaic/atom-bom/图纸&STEP模型/大腿内侧.STEP
130.0 x 357.5 x 57.7 mm
