Roboparty/roboto_origin/modules/Atom01_hardware/atom01_mechnaic/Atom01_battery/CATL_6.2Ah_battery.SLDPRT

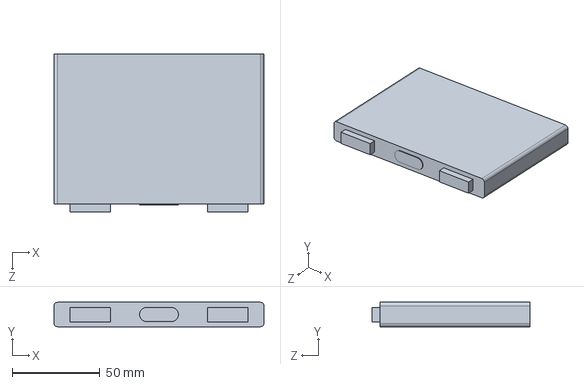
[picture p37: CAD file, 2025-12-31]
modules/Atom01_hardware/atom01_mechnaic/Atom01_battery/CATL_6.2Ah_battery.SLDPRT
120.0 x 14.0 x 90.0 mm
