Roboparty/roboto_origin/modules/atom01_description/meshes/right_knee_link.STL

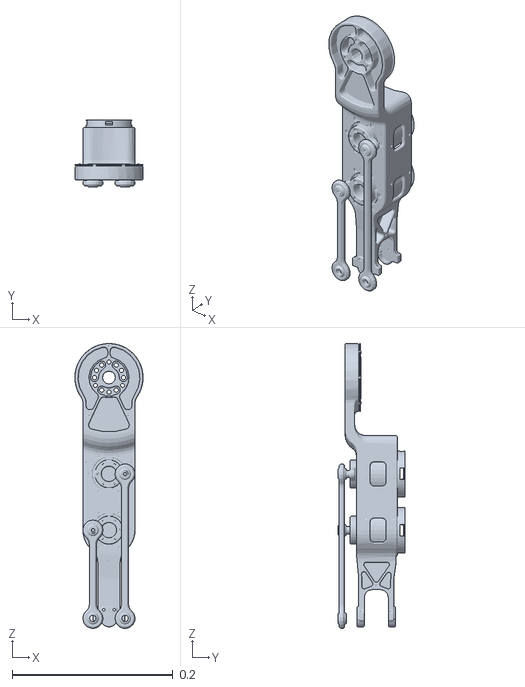
[picture p38: CAD file, 2025-12-31]
modules/atom01_description/meshes/right_knee_link.STL
0.085 x 0.0838 x 0.355
