Roboparty/roboto_origin/modules/Atom01_hardware/atom01_mechnaic/atom-bom/SW模型/GB╱T 70.1-2008[内六角圆柱头螺钉M3×6].step

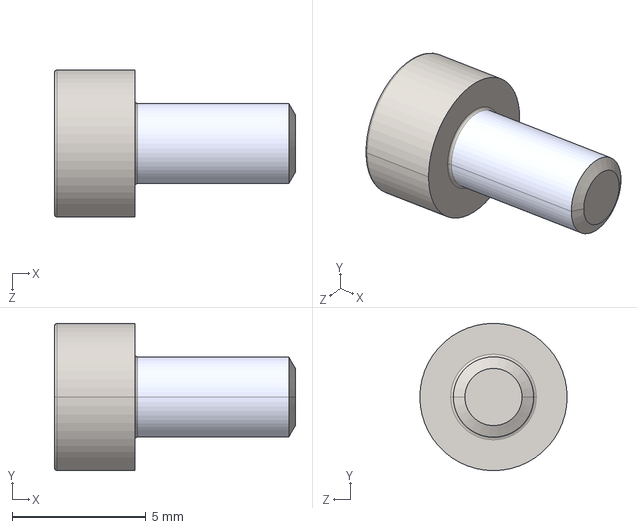
[picture p39: CAD file, 2025-12-31]
modules/Atom01_hardware/atom01_mechnaic/atom-bom/SW模型/GB╱T 70.1-2008[内六角圆柱头螺钉M3×6].step
9.00 x 5.50 x 5.50 mm
