Roboparty/roboto_origin/modules/Atom01_hardware/atom01_mechnaic/atom-bom/图纸&STEP模型/IMU载板.STEP

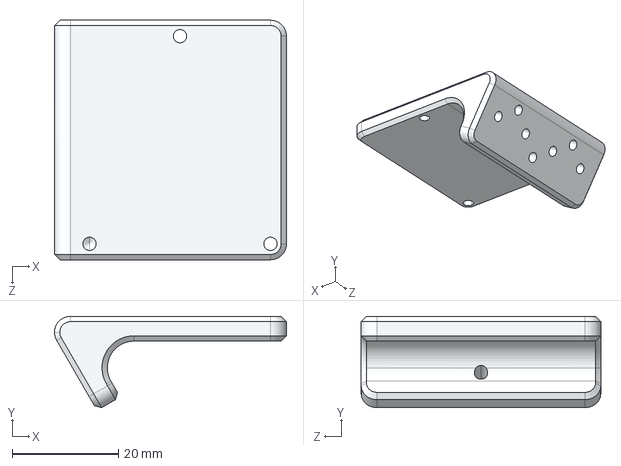
[picture p40: CAD file, 2025-12-31]
modules/Atom01_hardware/atom01_mechnaic/atom-bom/图纸&STEP模型/IMU载板.STEP
43.6 x 17.1 x 45.0 mm
