Roboparty/roboto_origin/modules/atom01_description/meshes/right_arm_roll_link.STL

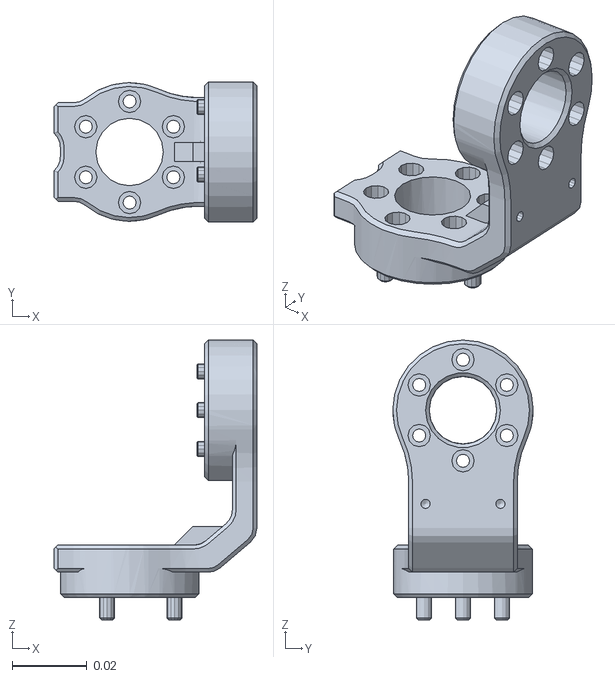
[picture p41: CAD file, 2025-12-31]
modules/atom01_description/meshes/right_arm_roll_link.STL
0.0542 x 0.0375 x 0.0747
