Roboparty/roboto_origin/modules/Atom01_hardware/atom01_mechnaic/atom-bom/SW模型/DM 4340 rau 3505 电机 3D.SLDPRT

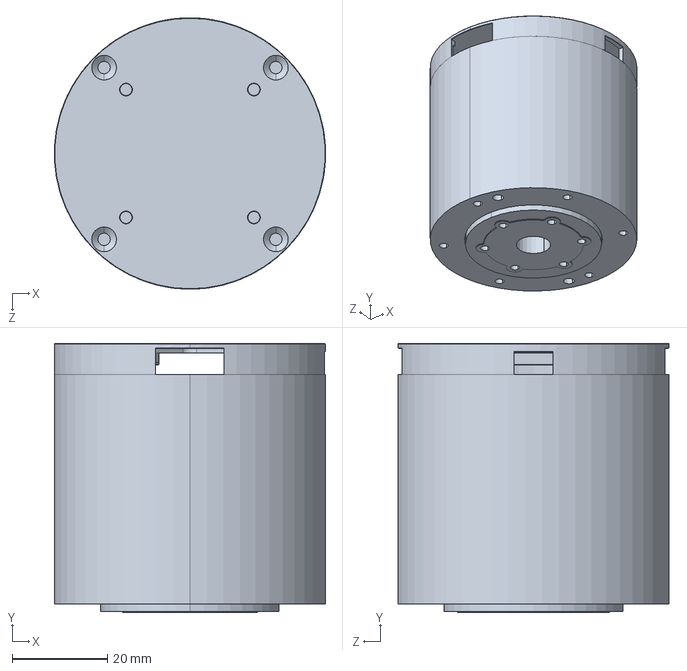
[picture p42: CAD file, 2025-12-31]
modules/Atom01_hardware/atom01_mechnaic/atom-bom/SW模型/DM 4340 rau 3505 电机 3D.SLDPRT
56.9 x 56.5 x 57.0 mm
