Roboparty/roboto_origin/modules/Atom01_hardware/atom01_mechnaic/atom-bom/图纸&STEP模型/通用连接件扩孔法兰.STEP

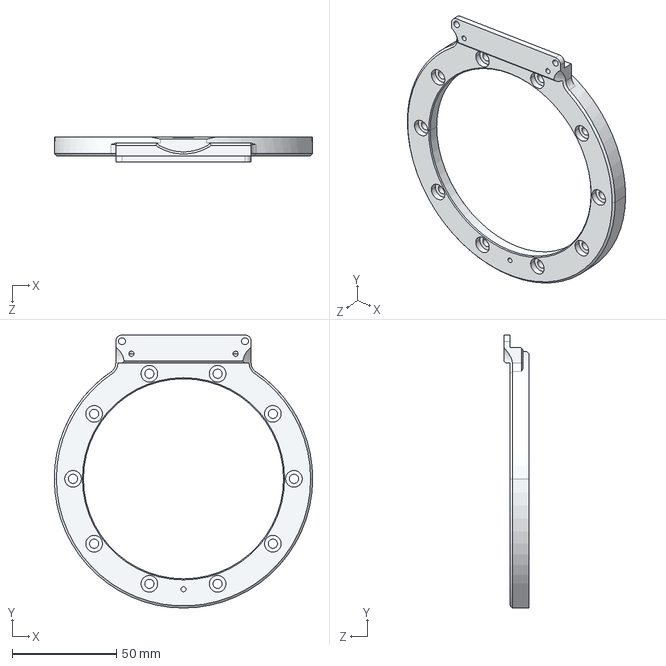
[picture p43: CAD file, 2025-12-31]
modules/Atom01_hardware/atom01_mechnaic/atom-bom/图纸&STEP模型/通用连接件扩孔法兰.STEP
124.0 x 131.0 x 12.0 mm
