Roboparty/roboto_origin/modules/Atom01_hardware/atom01_mechnaic/atom-id/大臂上部前侧.stp

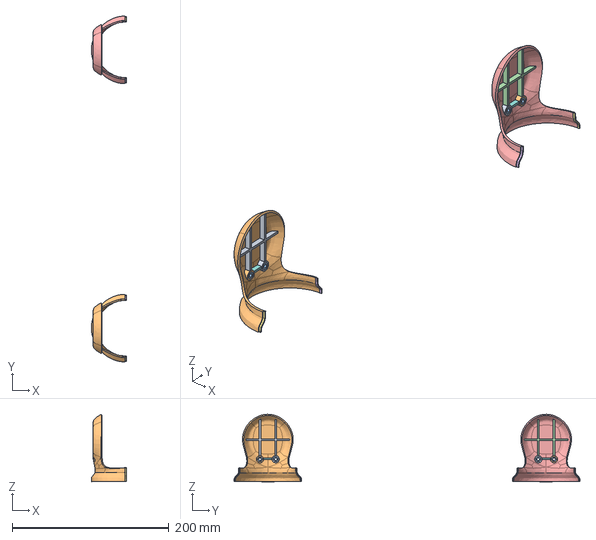
[picture p44: CAD file, 2025-12-31]
modules/Atom01_hardware/atom01_mechnaic/atom-id/大臂上部前侧.stp
45.3 x 442.0 x 86.3 mm
