Roboparty/roboto_origin/modules/atom01_description/meshes/right_ankle_pitch_link.STL

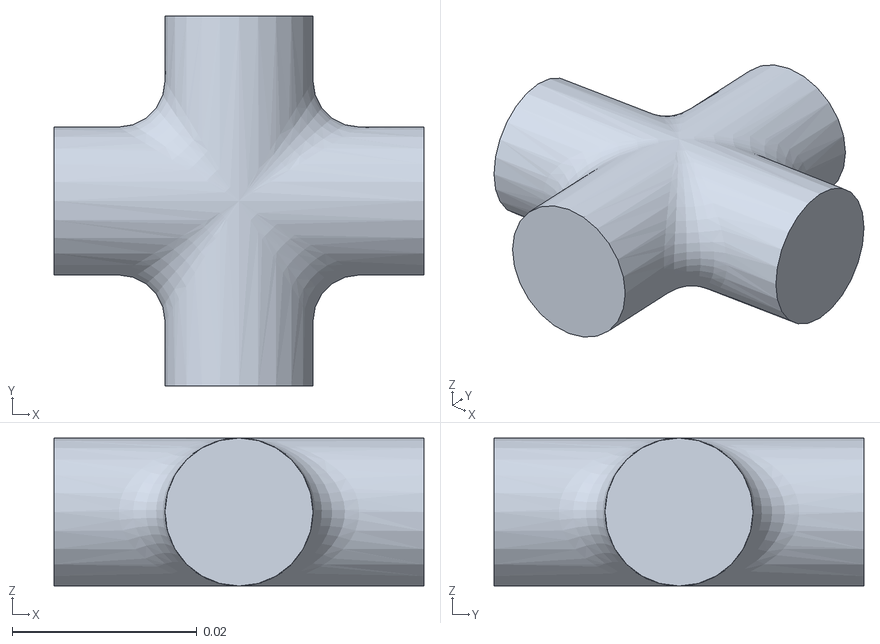
[picture p45: CAD file, 2025-12-31]
modules/atom01_description/meshes/right_ankle_pitch_link.STL
0.04 x 0.04 x 0.016
