Roboparty/roboto_origin/modules/Atom01_hardware/atom01_mechnaic/atom-bom/SW模型/GB╱T 70.1-2008[内六角圆柱头螺钉M4×8].step

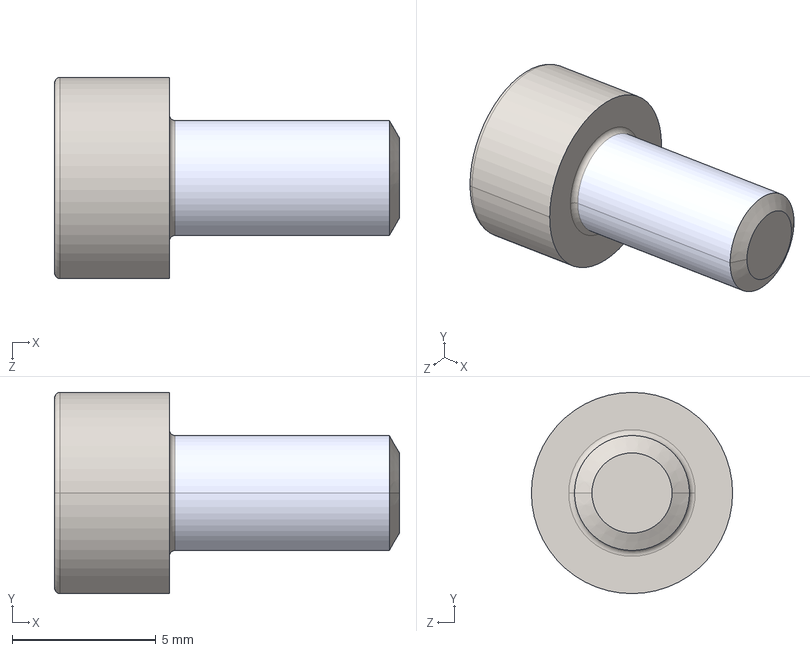
[picture p46: CAD file, 2025-12-31]
modules/Atom01_hardware/atom01_mechnaic/atom-bom/SW模型/GB╱T 70.1-2008[内六角圆柱头螺钉M4×8].step
12.0 x 7.00 x 7.00 mm
