Roboparty/roboto_origin/modules/Atom01_hardware/atom01_mechnaic/atom-id/脚底板.stp

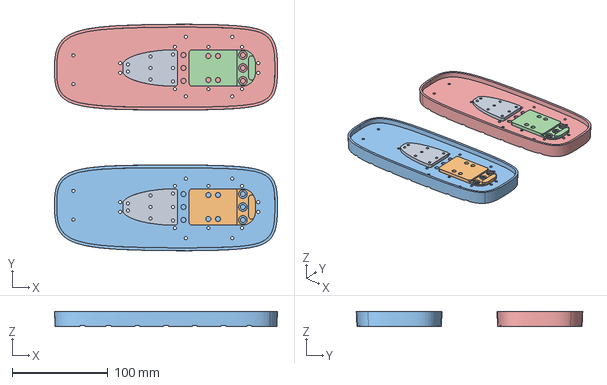
[picture p48: CAD file, 2025-12-31]
modules/Atom01_hardware/atom01_mechnaic/atom-id/脚底板.stp
232.6 x 236.3 x 16.0 mm
