Roboparty/roboto_origin/modules/atom01_description/meshes/right_thigh_roll_link.STL

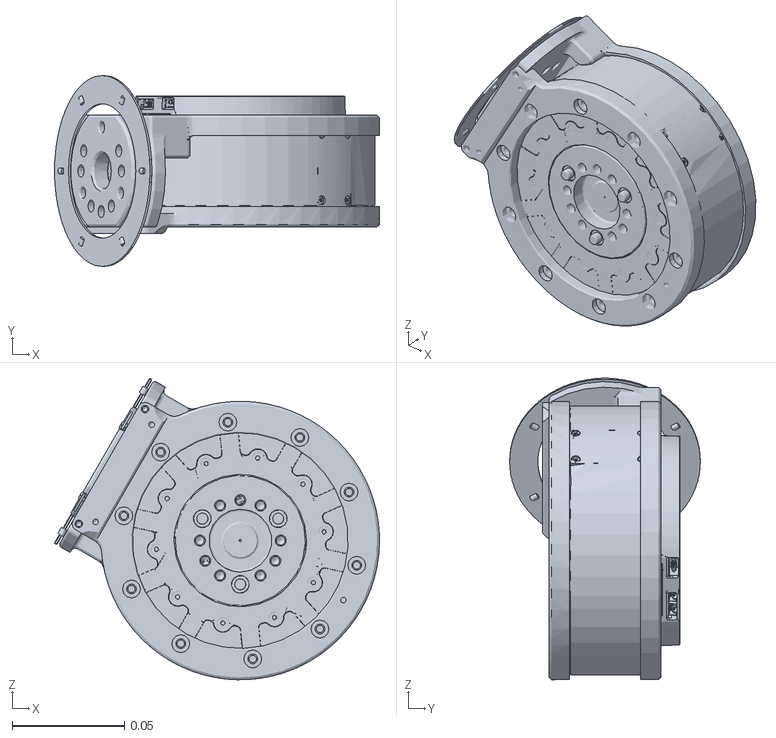
[picture p49: CAD file, 2025-12-31]
modules/atom01_description/meshes/right_thigh_roll_link.STL
0.145 x 0.085 x 0.134
