Roboparty/roboto_origin/modules/Atom01_hardware/atom01_mechnaic/atom-bom/SW模型/20cm脚.SLDPRT

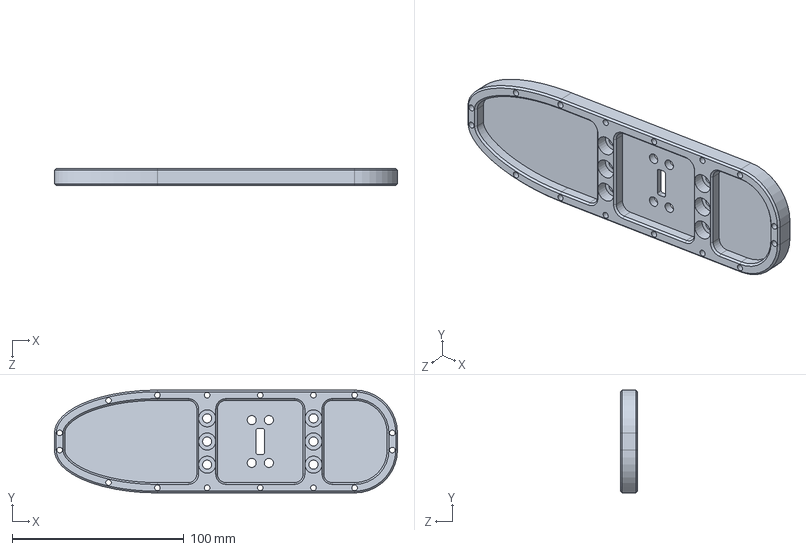
[picture p50: CAD file, 2025-12-31]
modules/Atom01_hardware/atom01_mechnaic/atom-bom/SW模型/20cm脚.SLDPRT
200.0 x 60.0 x 10.0 mm
