Roboparty/roboto_origin/modules/Atom01_hardware/atom01_mechnaic/atom-id/脚背.stp

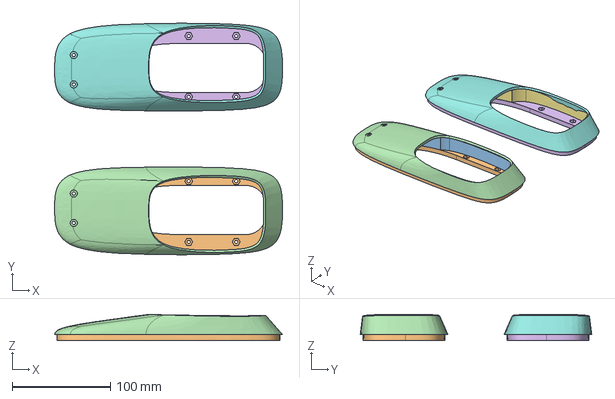
[picture p51: CAD file, 2025-12-31]
modules/Atom01_hardware/atom01_mechnaic/atom-id/脚背.stp
232.6 x 236.3 x 26.7 mm
