Roboparty/roboto_origin/modules/Atom01_hardware/atom01_mechnaic/atom-packngo/imu.SLDPRT

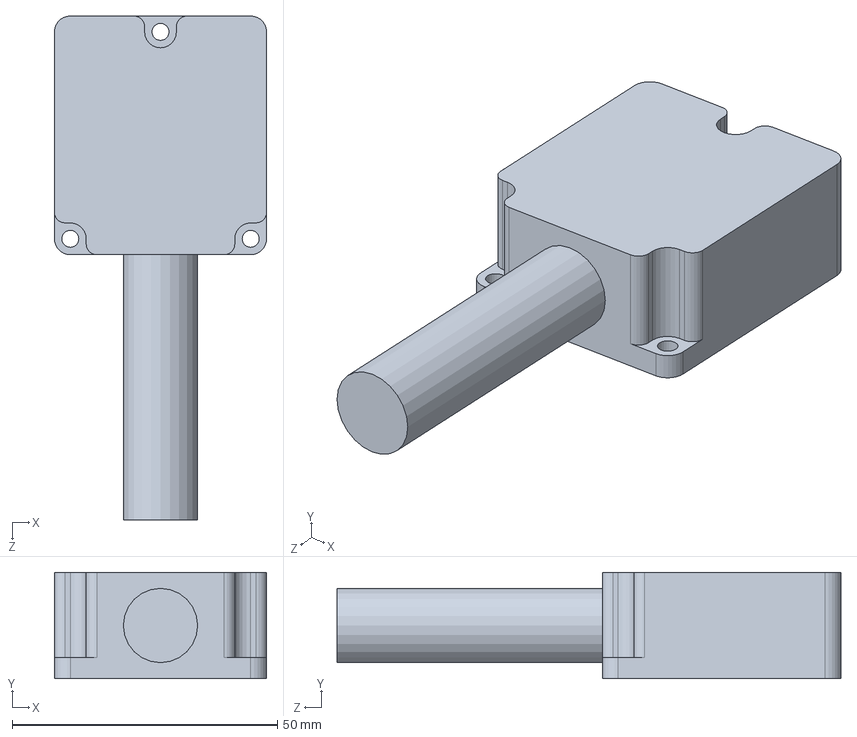
[picture p52: CAD file, 2025-12-31]
modules/Atom01_hardware/atom01_mechnaic/atom-packngo/imu.SLDPRT
40.0 x 20.0 x 95.0 mm
