Roboparty/roboto_origin/modules/Atom01_hardware/atom01_mechnaic/atom-bom/SW模型/腰部支撑.SLDPRT

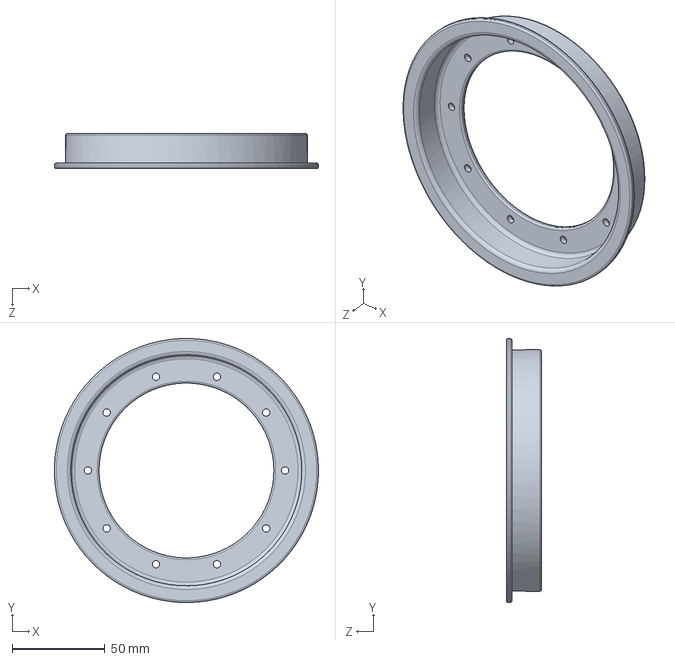
[picture p53: CAD file, 2025-12-31]
modules/Atom01_hardware/atom01_mechnaic/atom-bom/SW模型/腰部支撑.SLDPRT
142.0 x 142.0 x 19.0 mm
