Roboparty/roboto_origin/modules/Atom01_hardware/atom01_mechnaic/atom-bom/图纸&STEP模型/输出法兰连杆.STEP

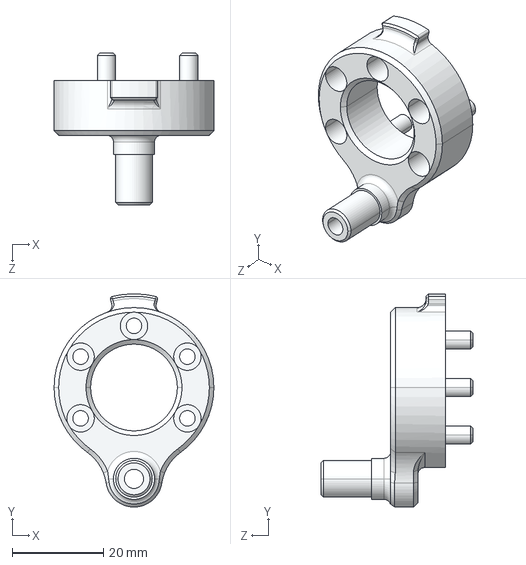
[picture p54: CAD file, 2025-12-31]
modules/Atom01_hardware/atom01_mechnaic/atom-bom/图纸&STEP模型/输出法兰连杆.STEP
35.0 x 46.6 x 33.3 mm
