Roboparty/roboto_origin/modules/Atom01_hardware/atom01_mechnaic/atom-id/大臂根部前侧.stp

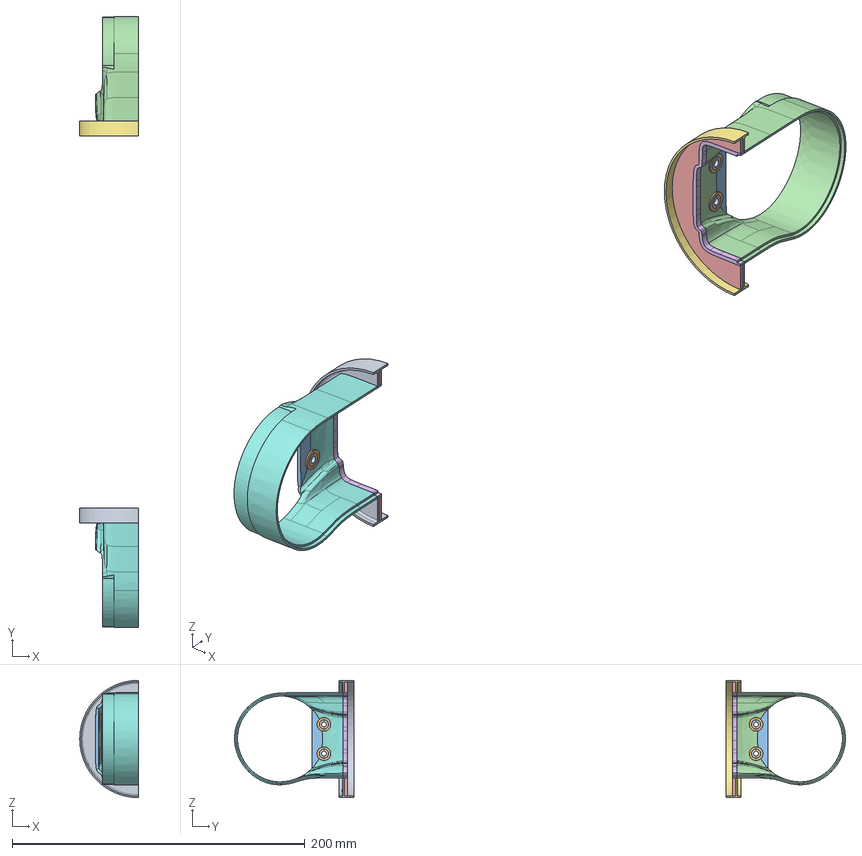
[picture p55: CAD file, 2025-12-31]
modules/Atom01_hardware/atom01_mechnaic/atom-id/大臂根部前侧.stp
40.1 x 417.7 x 80.2 mm
