Roboparty/roboto_origin/modules/Atom01_hardware/atom01_mechnaic/atom-bom/SW模型/侧板横板.SLDPRT

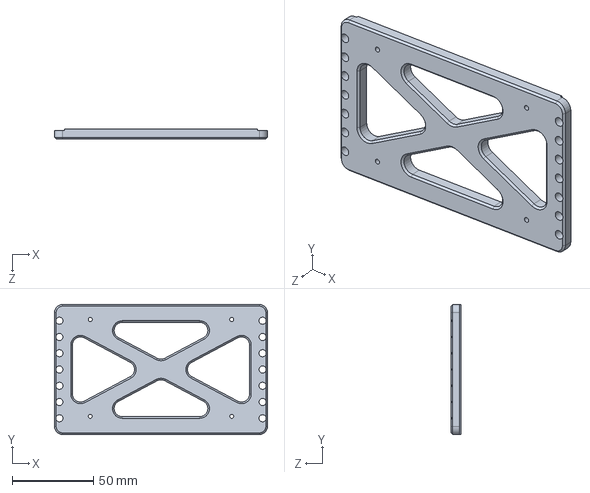
[picture p57: CAD file, 2025-12-31]
modules/Atom01_hardware/atom01_mechnaic/atom-bom/SW模型/侧板横板.SLDPRT
131.0 x 80.0 x 6.00 mm
