Roboparty/roboto_origin/modules/Atom01_hardware/atom01_mechnaic/atom-bom/图纸&STEP模型/胸腔前后夹板.STEP

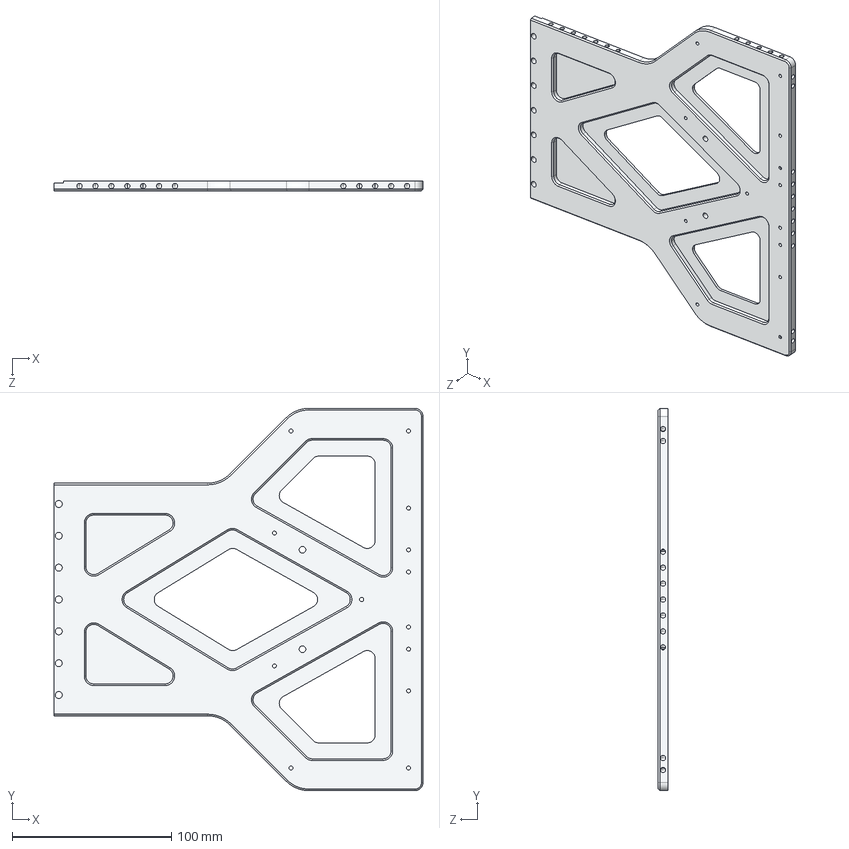
[picture p58: CAD file, 2025-12-31]
modules/Atom01_hardware/atom01_mechnaic/atom-bom/图纸&STEP模型/胸腔前后夹板.STEP
231.7 x 240.0 x 6.00 mm
