Roboparty/roboto_origin/modules/Atom01_hardware/atom01_mechnaic/atom-id/肩部吊环.stp

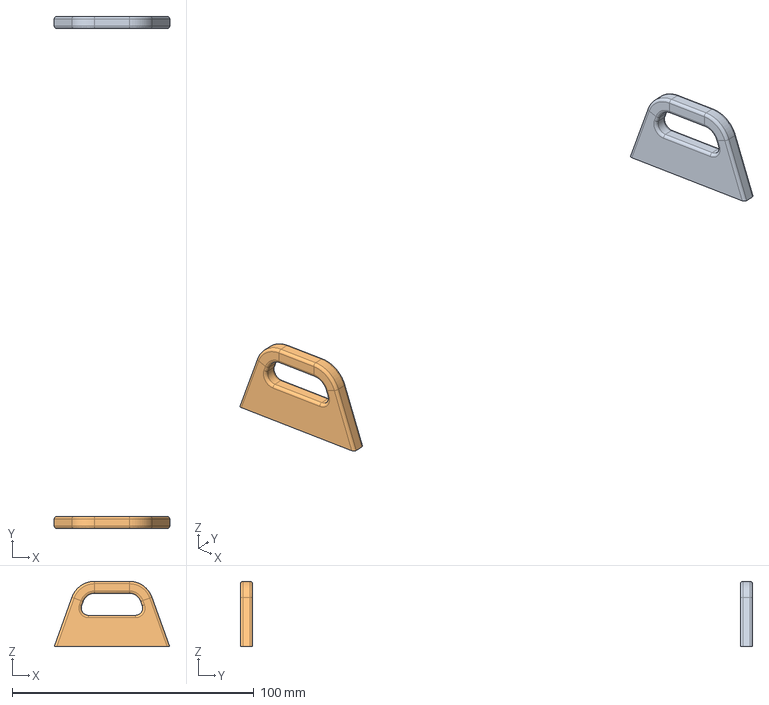
[picture p59: CAD file, 2025-12-31]
modules/Atom01_hardware/atom01_mechnaic/atom-id/肩部吊环.stp
47.8 x 211.7 x 27.1 mm
