Roboparty/roboto_origin/modules/atom01_description/meshes/torso_link.STL

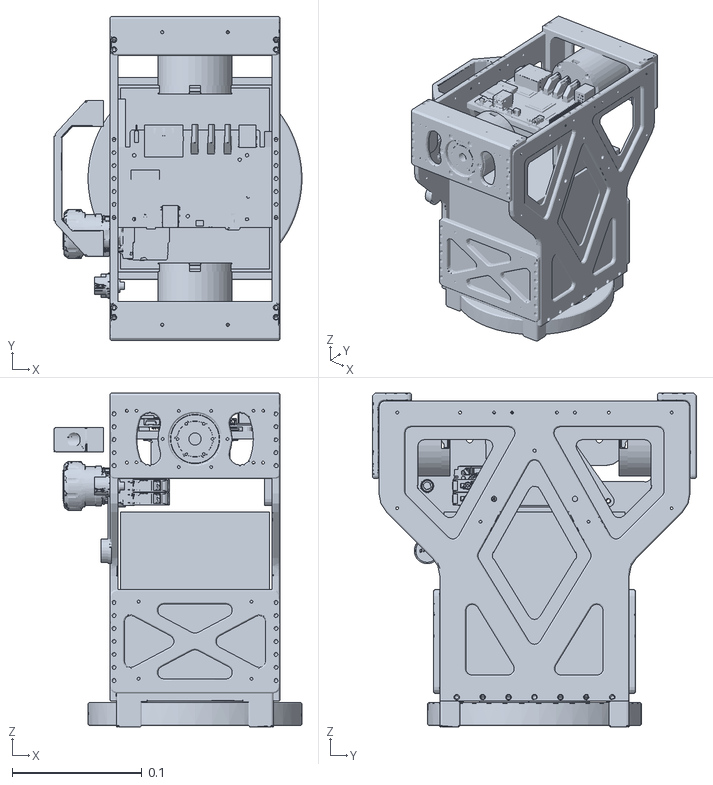
[picture p60: CAD file, 2025-12-31]
modules/atom01_description/meshes/torso_link.STL
0.191 x 0.25 x 0.258
