Roboparty/roboto_origin/modules/Atom01_hardware/atom01_mechnaic/atom-bom/图纸&STEP模型/髋夹板.STEP

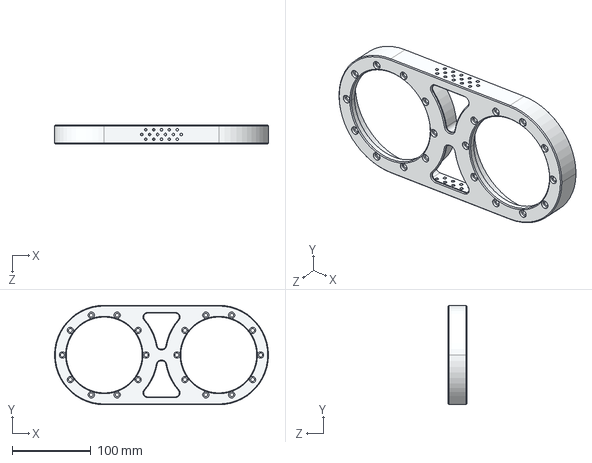
[picture p61: CAD file, 2025-12-31]
modules/Atom01_hardware/atom01_mechnaic/atom-bom/图纸&STEP模型/髋夹板.STEP
271.0 x 126.0 x 24.0 mm
