Roboparty/roboto_origin/modules/Atom01_hardware/atom01_mechnaic/atom-id/大腿根部.stp

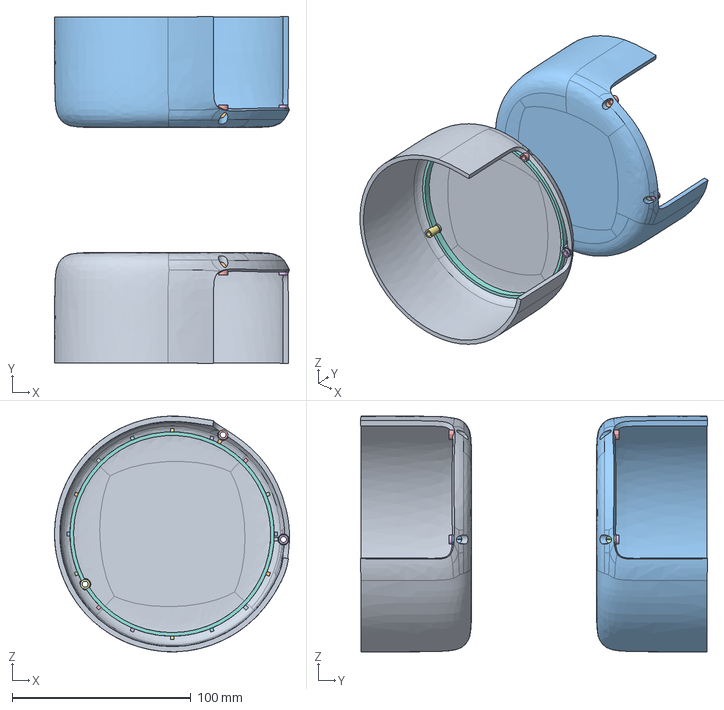
[picture p62: CAD file, 2025-12-31]
modules/Atom01_hardware/atom01_mechnaic/atom-id/大腿根部.stp
131.5 x 194.2 x 131.9 mm
