Roboparty/roboto_origin/modules/atom01_description/meshes/left_arm_yaw_link.STL

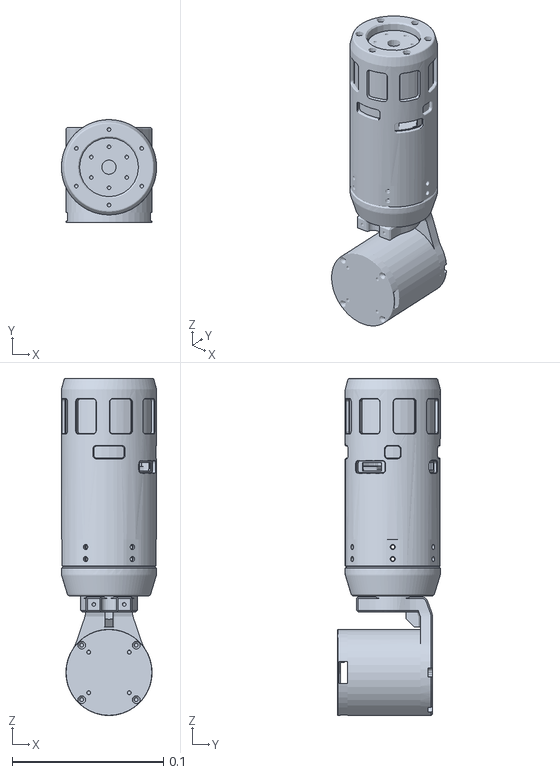
[picture p63: CAD file, 2025-12-31]
modules/atom01_description/meshes/left_arm_yaw_link.STL
0.063 x 0.068 x 0.223
