Roboparty/roboto_origin/modules/Atom01_hardware/atom01_mechnaic/atom-bom/SW模型/imu固定器.SLDPRT

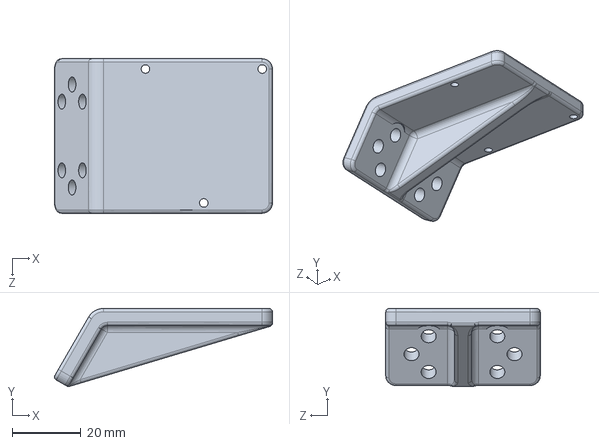
[picture p64: CAD file, 2025-12-31]
modules/Atom01_hardware/atom01_mechnaic/atom-bom/SW模型/imu固定器.SLDPRT
63.5 x 22.7 x 45.0 mm
