Roboparty/roboto_origin/modules/Atom01_hardware/atom01_mechnaic/atom-id/大臂上部后侧.stp

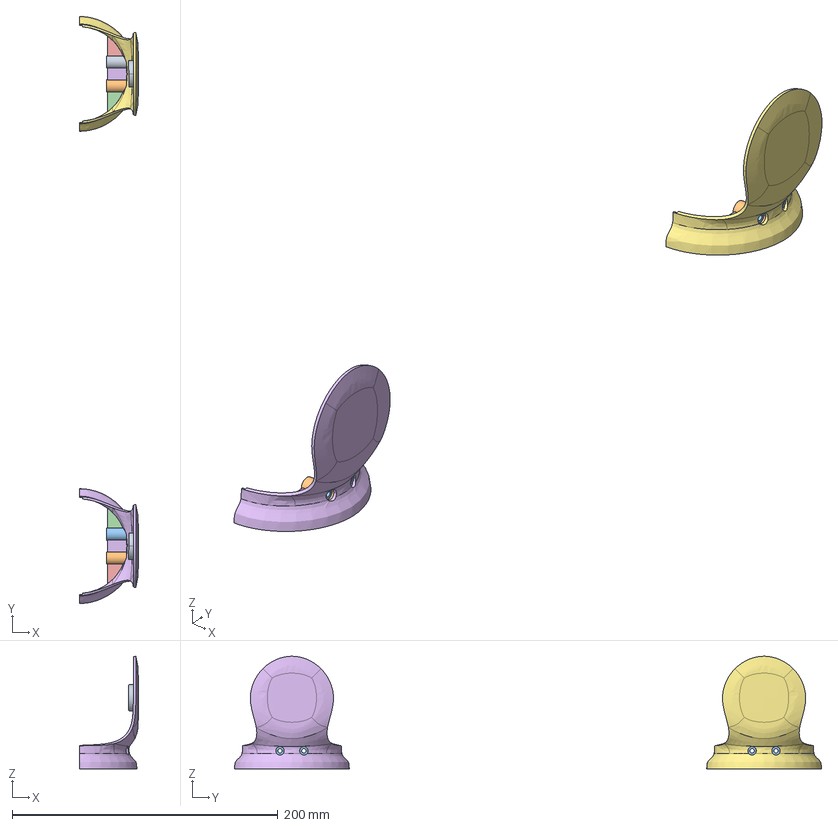
[picture p65: CAD file, 2025-12-31]
modules/Atom01_hardware/atom01_mechnaic/atom-id/大臂上部后侧.stp
44.1 x 442.0 x 84.8 mm
