Roboparty/roboto_origin/modules/Atom01_hardware/atom01_mechnaic/atom-packngo/通用连接件.SLDPRT

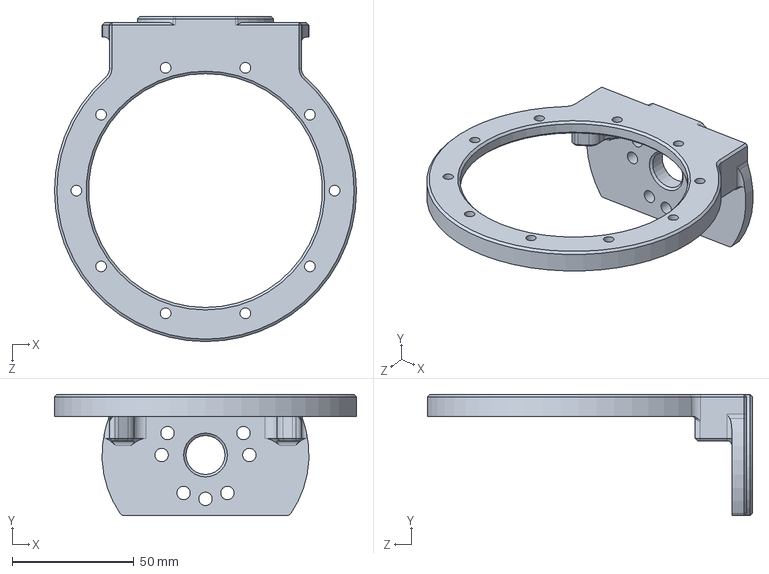
[picture p66: CAD file, 2025-12-31]
modules/Atom01_hardware/atom01_mechnaic/atom-packngo/通用连接件.SLDPRT
124.0 x 49.7 x 133.5 mm
