Roboparty/roboto_origin/modules/atom01_description/meshes/right_arm_pitch_link.STL

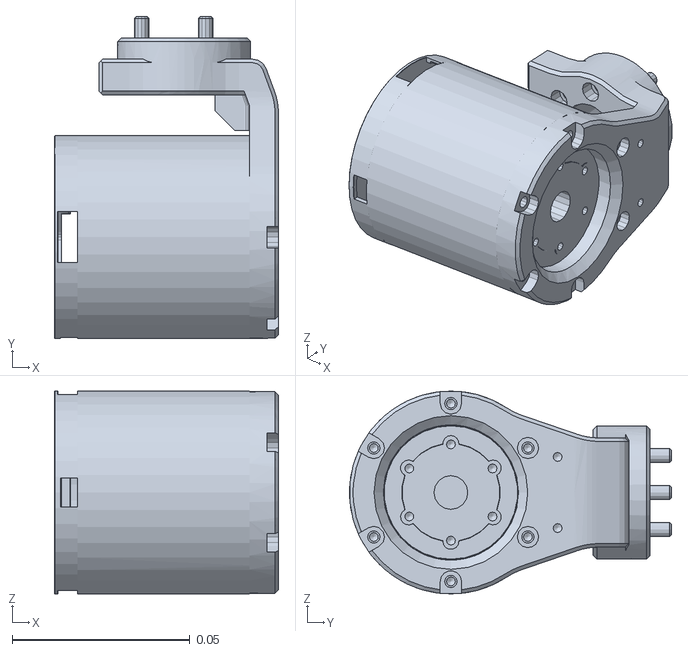
[picture p67: CAD file, 2025-12-31]
modules/atom01_description/meshes/right_arm_pitch_link.STL
0.063 x 0.0905 x 0.057
