Roboparty/roboto_origin/modules/Atom01_hardware/atom01_mechnaic/atom-bom/SW模型/脚踝横滚连接件.SLDPRT

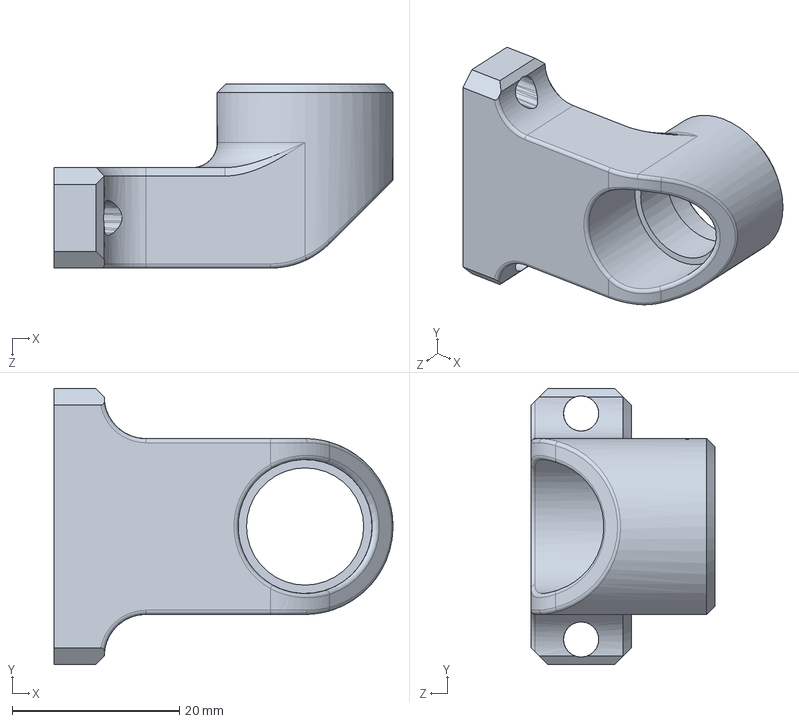
[picture p68: CAD file, 2025-12-31]
modules/Atom01_hardware/atom01_mechnaic/atom-bom/SW模型/脚踝横滚连接件.SLDPRT
40.5 x 33.0 x 22.0 mm
