Roboparty/roboto_origin/modules/Atom01_hardware/atom01_mechnaic/atom-id/手部（球型）.stp

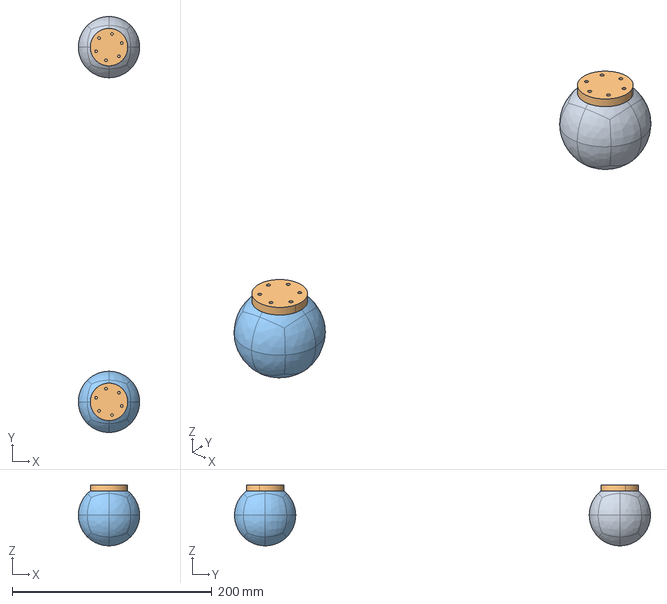
[picture p69: CAD file, 2025-12-31]
modules/Atom01_hardware/atom01_mechnaic/atom-id/手部（球型）.stp
61.4 x 416.9 x 60.9 mm
