Roboparty/roboto_origin/modules/Atom01_hardware/atom01_mechnaic/atom-bom/SW模型/小腿.SLDPRT

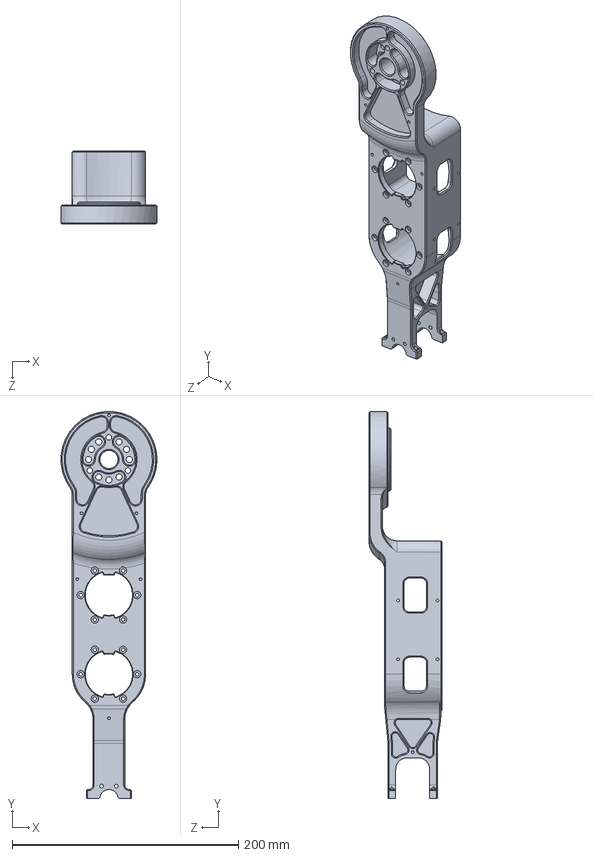
[picture p70: CAD file, 2025-12-31]
modules/Atom01_hardware/atom01_mechnaic/atom-bom/SW模型/小腿.SLDPRT
84.9 x 342.5 x 65.0 mm
