Roboparty/roboto_origin/modules/Atom01_hardware/atom01_mechnaic/atom-id/胸腔提手外侧.stp

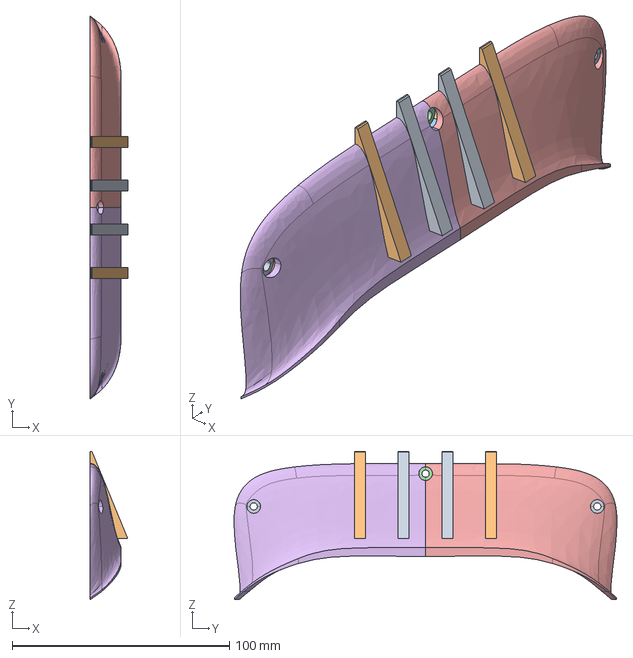
[picture p72: CAD file, 2025-12-31]
modules/Atom01_hardware/atom01_mechnaic/atom-id/胸腔提手外侧.stp
17.3 x 176.4 x 68.4 mm
