Roboparty/roboto_origin/modules/atom01_description/meshes/left_knee_link.STL

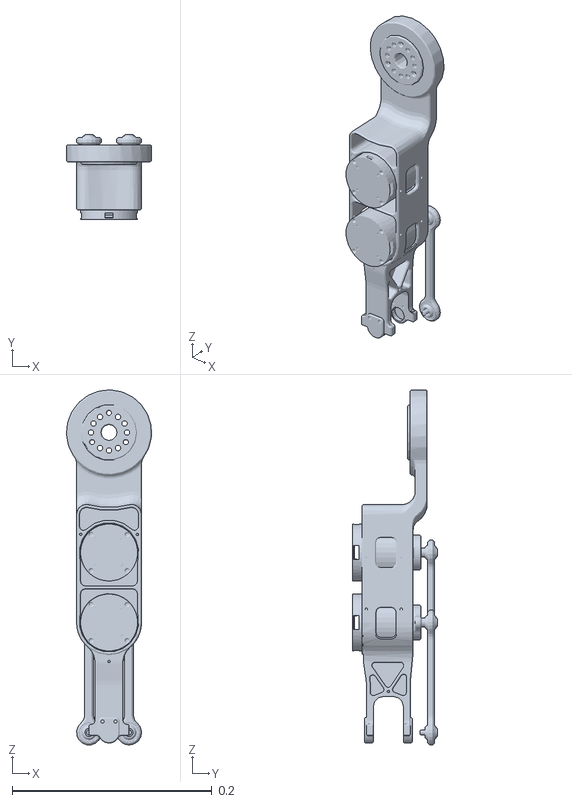
[picture p73: CAD file, 2025-12-31]
modules/atom01_description/meshes/left_knee_link.STL
0.0849 x 0.085 x 0.355
