Roboparty/roboto_origin/modules/Atom01_hardware/atom01_mechnaic/atom-bom/SW模型/滚动轴承.SLDPRT

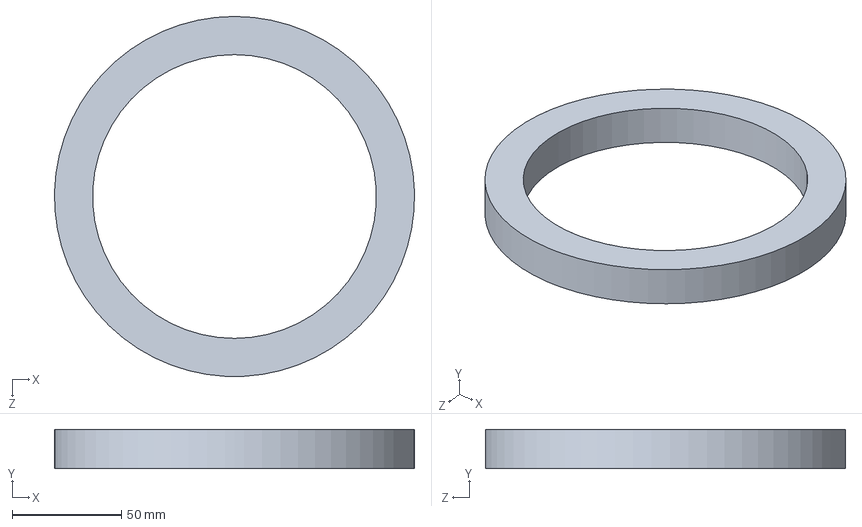
[picture p74: CAD file, 2025-12-31]
modules/Atom01_hardware/atom01_mechnaic/atom-bom/SW模型/滚动轴承.SLDPRT
164.9 x 18.0 x 165.0 mm
