Roboparty/roboto_origin/modules/Atom01_hardware/atom01_mechnaic/atom-id/小腿内侧.stp

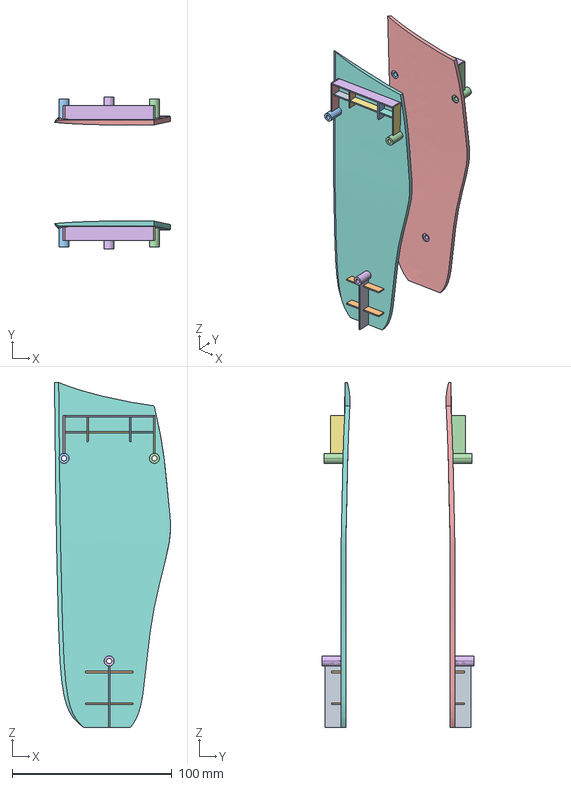
[picture p75: CAD file, 2025-12-31]
modules/Atom01_hardware/atom01_mechnaic/atom-id/小腿内侧.stp
72.7 x 95.6 x 216.2 mm
