Roboparty/roboto_origin/modules/Atom01_hardware/atom01_mechnaic/atom-bom/图纸&STEP模型/电池底盖.STEP

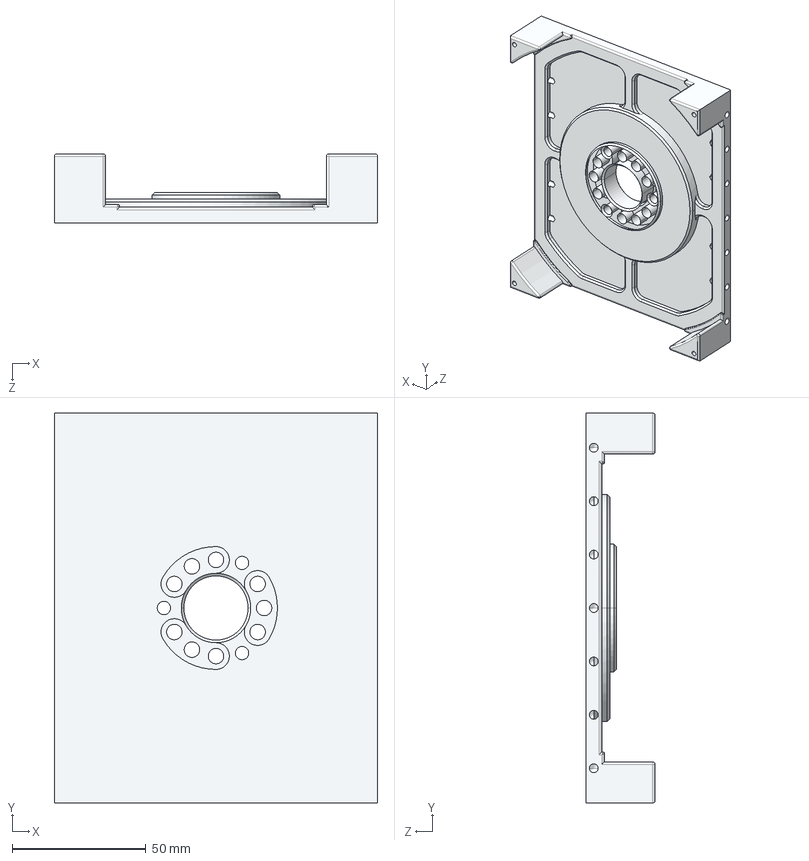
[picture p76: CAD file, 2025-12-31]
modules/Atom01_hardware/atom01_mechnaic/atom-bom/图纸&STEP模型/电池底盖.STEP
121.0 x 146.0 x 26.0 mm
