Roboparty/roboto_origin/modules/Atom01_hardware/atom01_mechnaic/atom-id/胸腔提手里侧.stp

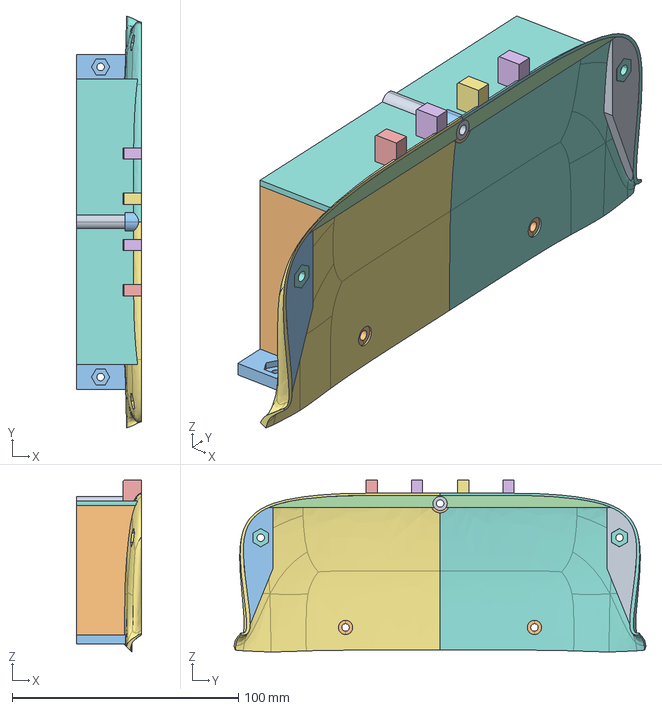
[picture p77: CAD file, 2025-12-31]
modules/Atom01_hardware/atom01_mechnaic/atom-id/胸腔提手里侧.stp
28.6 x 181.9 x 75.8 mm
