Roboparty/roboto_origin/modules/Atom01_hardware/atom01_mechnaic/atom-bom/SW模型/IMU反差.SLDPRT

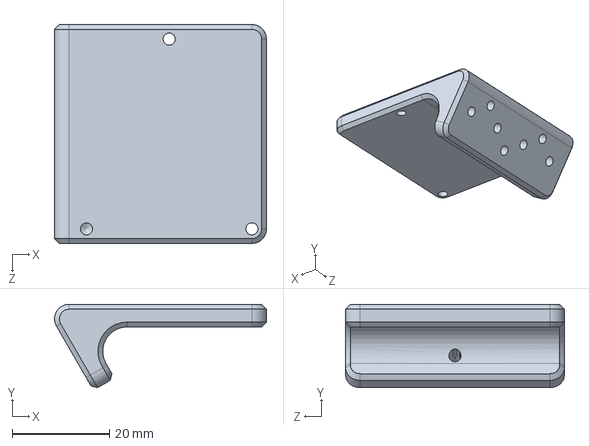
[picture p78: CAD file, 2025-12-31]
modules/Atom01_hardware/atom01_mechnaic/atom-bom/SW模型/IMU反差.SLDPRT
43.6 x 17.1 x 45.0 mm
