Roboparty/roboto_origin/modules/Atom01_hardware/atom01_mechnaic/atom-bom/图纸&STEP模型/脚底连杆.STEP

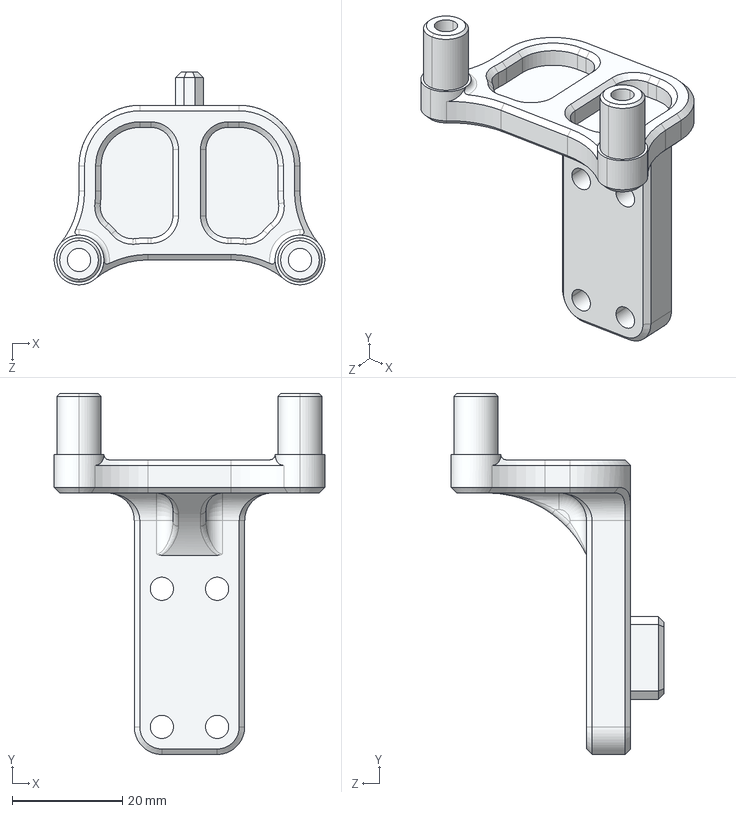
[picture p79: CAD file, 2025-12-31]
modules/Atom01_hardware/atom01_mechnaic/atom-bom/图纸&STEP模型/脚底连杆.STEP
49.0 x 65.4 x 38.5 mm
