Roboparty/roboto_origin/modules/Atom01_hardware/atom01_mechnaic/atom-id/胸腔透光片.stp

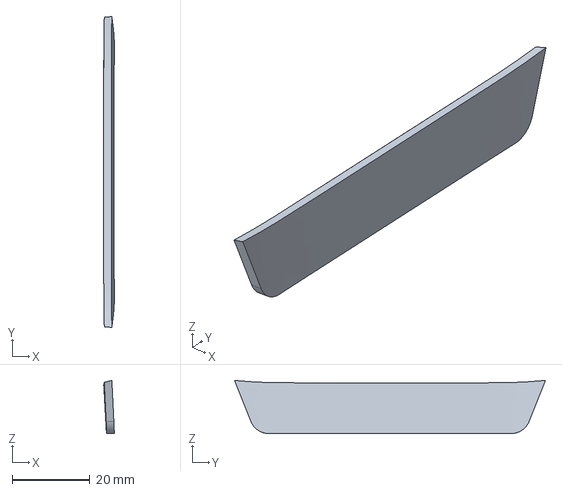
[picture p80: CAD file, 2025-12-31]
modules/Atom01_hardware/atom01_mechnaic/atom-id/胸腔透光片.stp
2.75 x 80.2 x 13.7 mm
