Roboparty/roboto_origin/modules/Atom01_hardware/atom01_mechnaic/atom-packngo/footbottom.SLDPRT

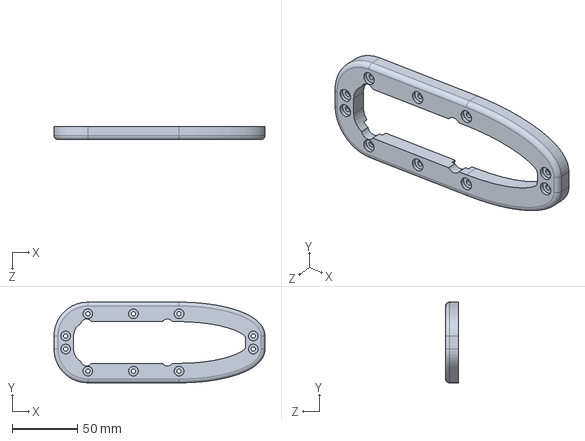
[picture p81: CAD file, 2025-12-31]
modules/Atom01_hardware/atom01_mechnaic/atom-packngo/footbottom.SLDPRT
162.0 x 62.0 x 10.0 mm
