Roboparty/roboto_origin/modules/atom01_description/meshes/right_thigh_yaw_link.STL

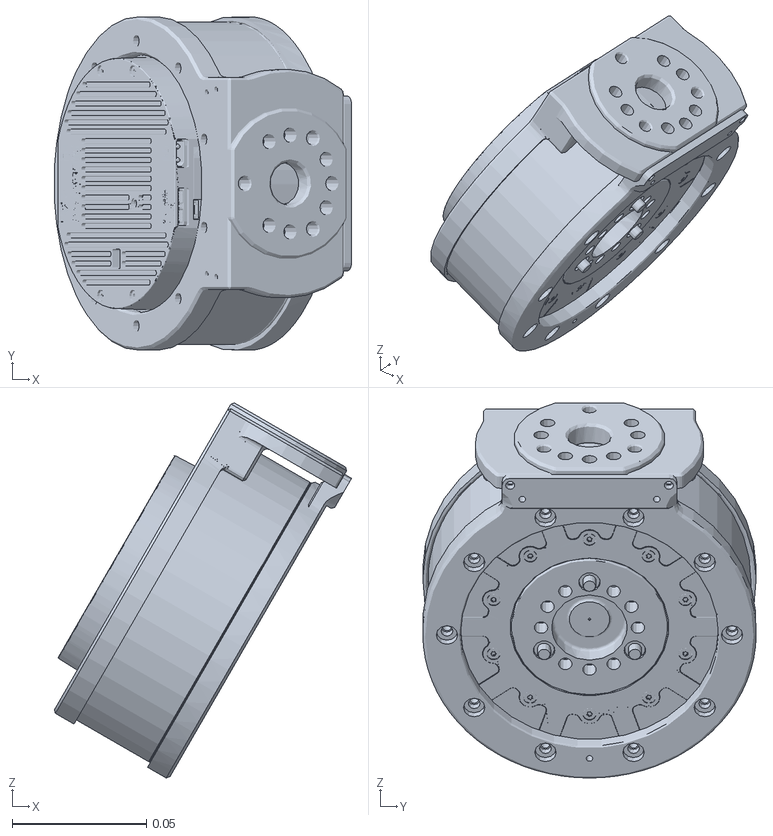
[picture p82: CAD file, 2025-12-31]
modules/atom01_description/meshes/right_thigh_yaw_link.STL
0.111 x 0.124 x 0.139
