Roboparty/roboto_origin/modules/Atom01_hardware/atom01_mechnaic/atom-bom/SW模型/GB╱T 4605-2003[推力滚针和保持架组件AXK6085].sldprt

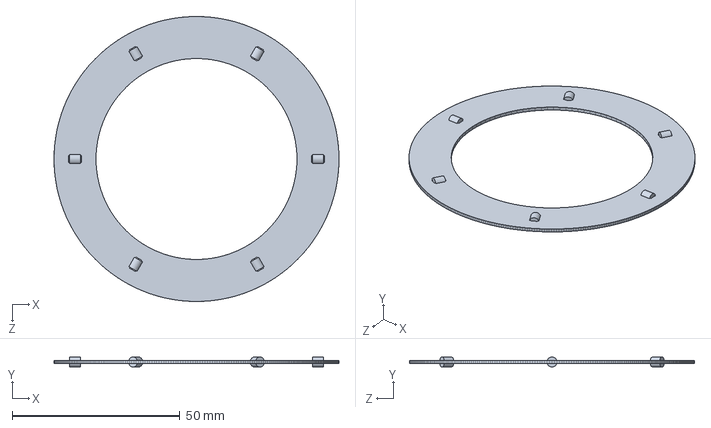
[picture p83: CAD file, 2025-12-31]
modules/Atom01_hardware/atom01_mechnaic/atom-bom/SW模型/GB╱T 4605-2003[推力滚针和保持架组件AXK6085].sldprt
85.0 x 3.00 x 85.0 mm
