Roboparty/roboto_origin/modules/Atom01_hardware/atom01_mechnaic/atom-id/小腿外侧.stp

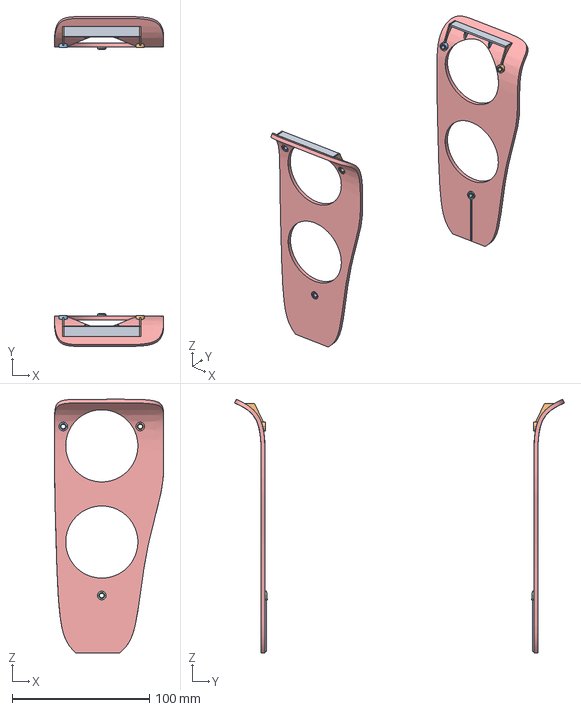
[picture p85: CAD file, 2025-12-31]
modules/Atom01_hardware/atom01_mechnaic/atom-id/小腿外侧.stp
79.6 x 240.2 x 184.5 mm
