Roboparty/roboto_origin/modules/atom01_description/meshes/right_thigh_pitch_link.STL

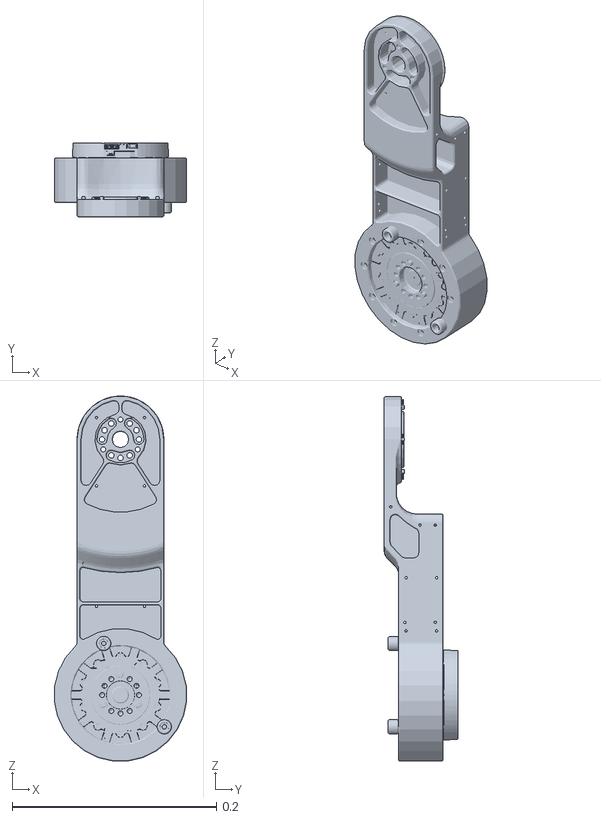
[picture p86: CAD file, 2025-12-31]
modules/atom01_description/meshes/right_thigh_pitch_link.STL
0.13 x 0.0722 x 0.357
