Roboparty/roboto_origin/modules/Atom01_hardware/atom01_mechnaic/atom-bom/图纸&STEP模型/atom手臂 - 副本 (2).STEP

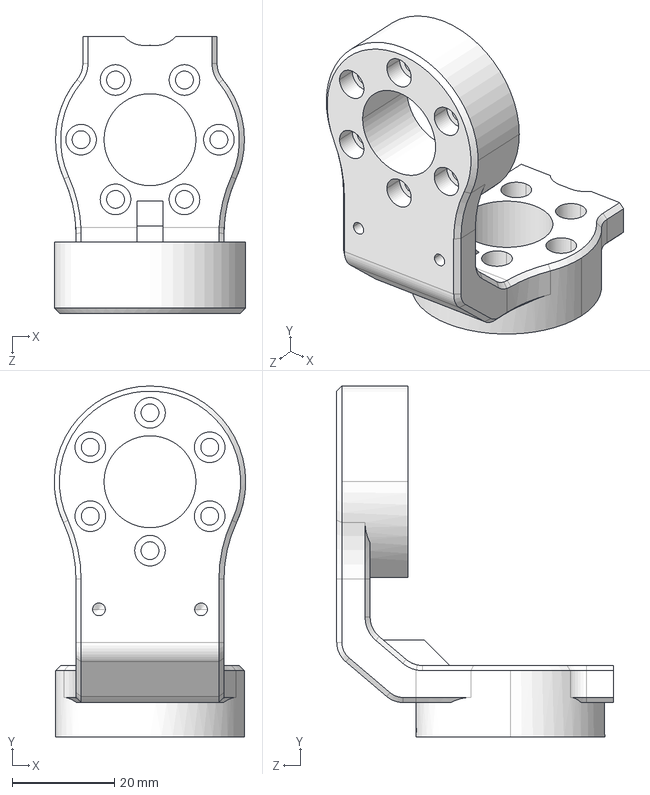
[picture p88: CAD file, 2025-12-31]
modules/Atom01_hardware/atom01_mechnaic/atom-bom/图纸&STEP模型/atom手臂 - 副本 (2).STEP
37.5 x 68.7 x 54.2 mm
