Roboparty/roboto_origin/modules/Atom01_hardware/atom01_mechnaic/atom-packngo/atom手臂 - 副本 (1).SLDPRT

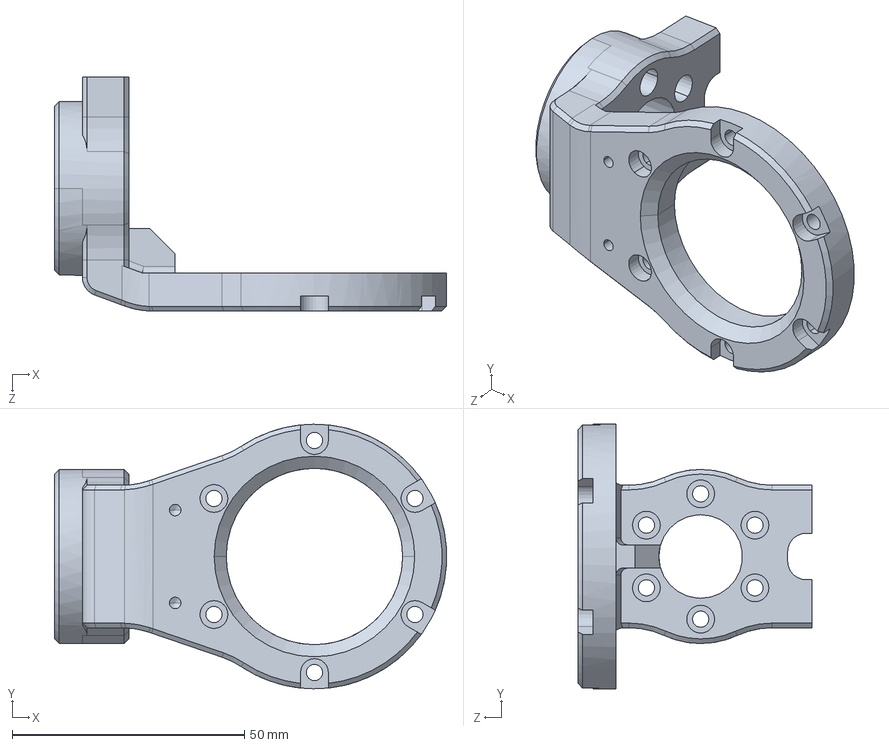
[picture p89: CAD file, 2025-12-31]
modules/Atom01_hardware/atom01_mechnaic/atom-packngo/atom手臂 - 副本 (1).SLDPRT
84.4 x 57.0 x 50.5 mm
