Roboparty/roboto_origin/modules/Atom01_hardware/atom01_mechnaic/atom-bom/SW模型/GB╱T 70.1-2008[内六角圆柱头螺钉M5×10].step

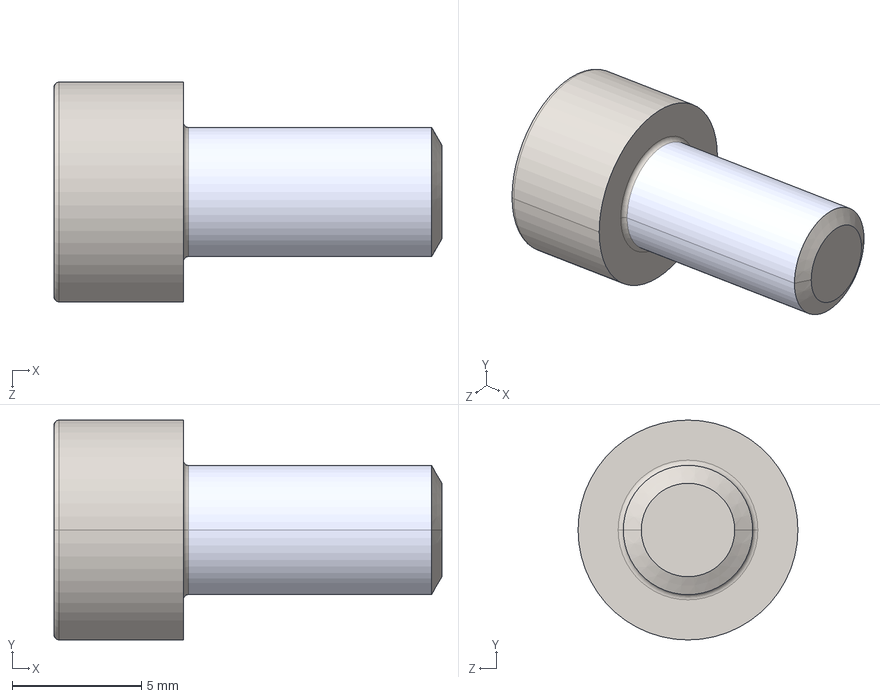
[picture p90: CAD file, 2025-12-31]
modules/Atom01_hardware/atom01_mechnaic/atom-bom/SW模型/GB╱T 70.1-2008[内六角圆柱头螺钉M5×10].step
15.0 x 8.50 x 8.50 mm
