Roboparty/roboto_origin/(list of files, cad)

Other CAD files:
modules/Atom01_hardware/atom01_mechnaic/atom_wire/wire/Wire01(xt30_2+2-xt30+gh1.25)/SW/U1~CONN-TH_XT30U-F~CONN-TH_XT30U-F~z1Un.SLDASM
modules/Atom01_hardware/atom01_mechnaic/atom_wire/wire/Wire03(xt30+gh1.25-xt30+gh1.25)/SW/xt30-F.SLDASM
modules/Atom01_hardware/atom01_mechnaic/atom_wire/wire/Wire02(xt30_2+2-xt30_2+2)/xt30-F.SLDASM
modules/Atom01_hardware/atom01_mechnaic/atom-packngo/定位尺寸.SLDASM
modules/Atom01_hardware/atom01_mechnaic/atom_wire/wire/Wire02(xt30_2+2-xt30_2+2)/U1~CONN-TH_XT30U-F~CONN-TH_XT30U-F~z1Un.SLDASM
modules/Atom01_hardware/atom01_mechnaic/atom_wire/wire/Wire01(xt30_2+2-xt30+gh1.25)/SW/xt30-F.SLDASM
modules/Atom01_hardware/atom01_mechnaic/atom_wire/wire/Wire02(xt30_2+2-xt30_2+2)/XT30.SLDASM
modules/Atom01_hardware/atom01_mechnaic/atom_wire/wire/Wire03(xt30+gh1.25-xt30+gh1.25)/SW/U1~CONN-TH_XT30U-F~CONN-TH_XT30U-F~z1Un.SLDASM
modules/Atom01_hardware/atom01_mechnaic/atom_wire/wire/Wire02(xt30_2+2-xt30_2+2)/wire.SLDASM
modules/Atom01_hardware/atom01_mechnaic/atom_wire/wire/Wire03(xt30+gh1.25-xt30+gh1.25)/SW/Assem1.SLDASM
modules/Atom01_hardware/atom01_mechnaic/atom-bom/SW模型/定位尺寸.SLDASM
modules/Atom01_hardware/atom01_mechnaic/atom-packngo/髋关节固定.SLDPRT
modules/Atom01_hardware/atom01_mechnaic/atom_wire/wire/Wire02(xt30_2+2-xt30_2+2)/XT30(2+2).SLDPRT
modules/Atom01_hardware/atom01_mechnaic/atom_wire/wire/Wire03(xt30+gh1.25-xt30+gh1.25)/SW/CONN-TH_XT30U-F~CONN-TH_XT30U-F~z1Un.SLDPRT
modules/Atom01_hardware/atom01_mechnaic/atom_wire/Step/XT30(2+2).step
modules/Atom01_hardware/atom01_mechnaic/atom_wire/wire/Wire02(xt30_2+2-xt30_2+2)/Board~z1Un.SLDPRT
modules/Atom01_hardware/atom01_mechnaic/atom-packngo/镜向GB╱T 9163-2001[向心关节轴承（G系列）8].SLDPRT
modules/Atom01_hardware/atom01_mechnaic/atom_wire/wire/Wire01(xt30_2+2-xt30+gh1.25)/SW/CONN-TH_XT30U-F~CONN-TH_XT30U-F~z1Un.SLDPRT
modules/Atom01_hardware/atom01_mechnaic/atom_wire/wire/Wire03(xt30+gh1.25-xt30+gh1.25)/SW/Board~z1Un.SLDPRT
modules/Atom01_hardware/atom01_mechnaic/atom-id/腰部下册.stp
modules/Atom01_hardware/atom01_mechnaic/atom-id/胸腔肩部.stp
modules/Atom01_hardware/atom01_mechnaic/atom-packngo/限位销.SLDPRT
modules/Atom01_hardware/atom01_mechnaic/atom_wire/wire/Wire02(xt30_2+2-xt30_2+2)/CONN-TH_XT30U-F~CONN-TH_XT30U-F~z1Un.SLDPRT
modules/Atom01_hardware/atom01_mechnaic/atom-packngo/长连杆.SLDPRT
modules/Atom01_hardware/atom01_mechnaic/atom_wire/wire/Wire01(xt30_2+2-xt30+gh1.25)/SW/XT30(2+2).SLDPRT
modules/Atom01_hardware/atom01_mechnaic/atom_wire/wire/Wire03(xt30+gh1.25-xt30+gh1.25)/SW/XT30(2+2).SLDPRT
modules/Atom01_hardware/atom01_mechnaic/atom-packngo/侧板横板.SLDPRT
modules/Atom01_hardware/atom01_mechnaic/atom_wire/wire/Wire01(xt30_2+2-xt30+gh1.25)/SW/GH1.25.SLDPRT
modules/Atom01_hardware/atom01_mechnaic/atom_wire/wire/Wire01(xt30_2+2-xt30+gh1.25)/SW/Board~z1Un.SLDPRT
modules/Atom01_hardware/atom01_mechnaic/atom_wire/wire/Wire03(xt30+gh1.25-xt30+gh1.25)/SW/GH1.25.SLDPRT
modules/atom01_description/meshes/left_thigh_roll_link.STL
modules/Atom01_hardware/atom01_mechnaic/atom-packngo/电池底盖.SLDPRT
modules/Atom01_hardware/atom01_mechnaic/atom_wire/wire/Wire02(xt30_2+2-xt30_2+2)/GH1.25.SLDPRT
modules/Atom01_hardware/atom01_mechnaic/atom-packngo/髋夹板.SLDPRT
modules/Atom01_hardware/atom01_mechnaic/atom-packngo/腰部支撑.SLDPRT
modules/Atom01_hardware/atom01_mechnaic/atom-bom/图纸&STEP模型/20cm脚.STEP
modules/Atom01_hardware/atom01_mechnaic/atom-bom/图纸&STEP模型/腰部支撑.STEP
modules/Atom01_hardware/atom01_mechnaic/atom-packngo/通用连接件扩孔法兰.SLDPRT
modules/atom01_description/meshes/left_arm_roll_link.STL
modules/Atom01_hardware/atom01_mechnaic/atom-packngo/imu固定器.SLDPRT
modules/Atom01_hardware/atom01_mechnaic/atom-bom/图纸&STEP模型/通用连接件.STEP
modules/Atom01_hardware/atom01_mechnaic/atom-packngo/脚底板.SLDPRT
modules/atom01_description/meshes/left_arm_pitch_link.STL
modules/Atom01_hardware/atom01_mechnaic/atom-packngo/滚动轴承.SLDPRT
modules/atom01_description/meshes/right_elbow_pitch_link.STL
modules/Atom01_hardware/atom01_mechnaic/atom-packngo/脚踝横滚连接件.SLDPRT
modules/Atom01_hardware/atom01_mechnaic/atom-bom/SW模型/髋关节固定.SLDPRT
modules/Atom01_hardware/atom01_mechnaic/atom-bom/图纸&STEP模型/atom手臂 - 副本 (4).STEP
modules/Atom01_hardware/atom01_mechnaic/atom-packngo/短连杆.SLDPRT
modules/atom01_description/meshes/right_arm_yaw_link.STL
modules/Atom01_hardware/atom01_mechnaic/atom-packngo/小腿.SLDPRT
modules/atom01_description/meshes/left_ankle_pitch_link.STL
modules/Atom01_hardware/atom01_mechnaic/atom-bom/SW模型/imu.SLDPRT
modules/atom01_description/meshes/right_elbow_yaw_link.STL
modules/Atom01_hardware/atom01_mechnaic/atom-bom/图纸&STEP模型/侧板横板.STEP
modules/Atom01_hardware/atom01_mechnaic/atom-packngo/GB╱T 4605-2003[推力滚针和保持架组件AXK6085].sldprt
modules/atom01_description/meshes/left_elbow_pitch_link.STL
modules/Atom01_hardware/atom01_mechnaic/atom-packngo/肩膀.SLDPRT
modules/Atom01_hardware/atom01_mechnaic/Atom01_battery/battery.SLDDRW
modules/Atom01_hardware/atom01_mechnaic/Atom01_battery/battery_controller.SLDPRT
modules/Atom01_hardware/atom01_mechnaic/atom-bom/SW模型/16x40十字轴承.SLDPRT
modules/Atom01_hardware/atom01_mechnaic/atom-bom/SW模型/270x60x70电池.SLDPRT
modules/Atom01_hardware/atom01_mechnaic/atom-bom/SW模型/GB╱T 70.1-2008[内六角圆柱头螺钉M3×12].step
modules/Atom01_hardware/atom01_mechnaic/atom-bom/SW模型/GB╱T 70.1-2008[内六角圆柱头螺钉M3×16].step
modules/Atom01_hardware/atom01_mechnaic/atom-bom/SW模型/GB╱T 70.1-2008[内六角圆柱头螺钉M3×8].step
modules/Atom01_hardware/atom01_mechnaic/atom-bom/SW模型/GB╱T 70.1-2008[内六角圆柱头螺钉M4×10].step
modules/Atom01_hardware/atom01_mechnaic/atom-bom/SW模型/GB╱T 70.1-2008[内六角圆柱头螺钉M4×12].step
modules/Atom01_hardware/atom01_mechnaic/atom-bom/SW模型/GB╱T 70.1-2008[内六角圆柱头螺钉M4×16].step
modules/Atom01_hardware/atom01_mechnaic/atom-bom/SW模型/GB╱T 9163-2001[向心关节轴承（G系列）8].sldprt
modules/Atom01_hardware/atom01_mechnaic/atom-bom/SW模型/PCB固定.SLDPRT
modules/Atom01_hardware/atom01_mechnaic/atom-bom/SW模型/atom手臂 - 副本 (1).SLDPRT
modules/Atom01_hardware/atom01_mechnaic/atom-bom/SW模型/atom手臂 - 副本 (2).SLDPRT
modules/Atom01_hardware/atom01_mechnaic/atom-bom/SW模型/atom手臂 - 副本 (3).SLDPRT
modules/Atom01_hardware/atom01_mechnaic/atom-bom/SW模型/atom手臂 - 副本 (4).SLDPRT
modules/Atom01_hardware/atom01_mechnaic/atom-bom/SW模型/大腿内侧.SLDPRT
modules/Atom01_hardware/atom01_mechnaic/atom-bom/SW模型/小腿轴承锁.SLDPRT
modules/Atom01_hardware/atom01_mechnaic/atom-bom/SW模型/平头M4x10螺丝.SLDPRT
modules/Atom01_hardware/atom01_mechnaic/atom-bom/SW模型/平头M5x16螺丝.SLDPRT
modules/Atom01_hardware/atom01_mechnaic/atom-bom/SW模型/短连杆.SLDPRT
modules/Atom01_hardware/atom01_mechnaic/atom-bom/SW模型/肩膀.SLDPRT
modules/Atom01_hardware/atom01_mechnaic/atom-bom/SW模型/胸腔前后夹板.SLDDRW
modules/Atom01_hardware/atom01_mechnaic/atom-bom/SW模型/脚底板.SLDPRT
modules/Atom01_hardware/atom01_mechnaic/atom-bom/SW模型/脚底连杆.SLDPRT
modules/Atom01_hardware/atom01_mechnaic/atom-bom/SW模型/输出法兰连杆.SLDPRT
modules/Atom01_hardware/atom01_mechnaic/atom-bom/SW模型/通用连接件.SLDPRT
modules/Atom01_hardware/atom01_mechnaic/atom-bom/SW模型/通用连接件扩孔法兰.SLDPRT
modules/Atom01_hardware/atom01_mechnaic/atom-bom/SW模型/镜向16x40十字轴承.SLDPRT
modules/Atom01_hardware/atom01_mechnaic/atom-bom/SW模型/镜向GB╱T 9163-2001[向心关节轴承（G系列）8].SLDPRT
modules/Atom01_hardware/atom01_mechnaic/atom-bom/SW模型/限位销.SLDPRT
modules/Atom01_hardware/atom01_mechnaic/atom-bom/SW模型/髋夹板.SLDPRT
modules/Atom01_hardware/atom01_mechnaic/atom-bom/图纸&STEP模型/20cm脚.SLDDRW
modules/Atom01_hardware/atom01_mechnaic/atom-bom/图纸&STEP模型/IMU反差.SLDDRW
modules/Atom01_hardware/atom01_mechnaic/atom-bom/图纸&STEP模型/atom手臂 - 副本 (1).SLDDRW
modules/Atom01_hardware/atom01_mechnaic/atom-bom/图纸&STEP模型/atom手臂 - 副本 (1).SLDPRT
modules/Atom01_hardware/atom01_mechnaic/atom-bom/图纸&STEP模型/atom手臂 - 副本 (1).STEP
modules/Atom01_hardware/atom01_mechnaic/atom-bom/图纸&STEP模型/atom手臂 - 副本 (2).SLDDRW
modules/Atom01_hardware/atom01_mechnaic/atom-bom/图纸&STEP模型/atom手臂 - 副本 (3).SLDDRW
modules/Atom01_hardware/atom01_mechnaic/atom-bom/图纸&STEP模型/atom手臂 - 副本 (4).SLDDRW
modules/Atom01_hardware/atom01_mechnaic/atom-bom/图纸&STEP模型/侧板横板.SLDDRW
modules/Atom01_hardware/atom01_mechnaic/atom-bom/图纸&STEP模型/大腿内侧.SLDDRW
modules/Atom01_hardware/atom01_mechnaic/atom-bom/图纸&STEP模型/小腿.SLDDRW
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
