Roboparty/roboto_origin/modules/Atom01_hardware/atom01_mechnaic/atom-bom/图纸&STEP模型/IMU载板.pdf

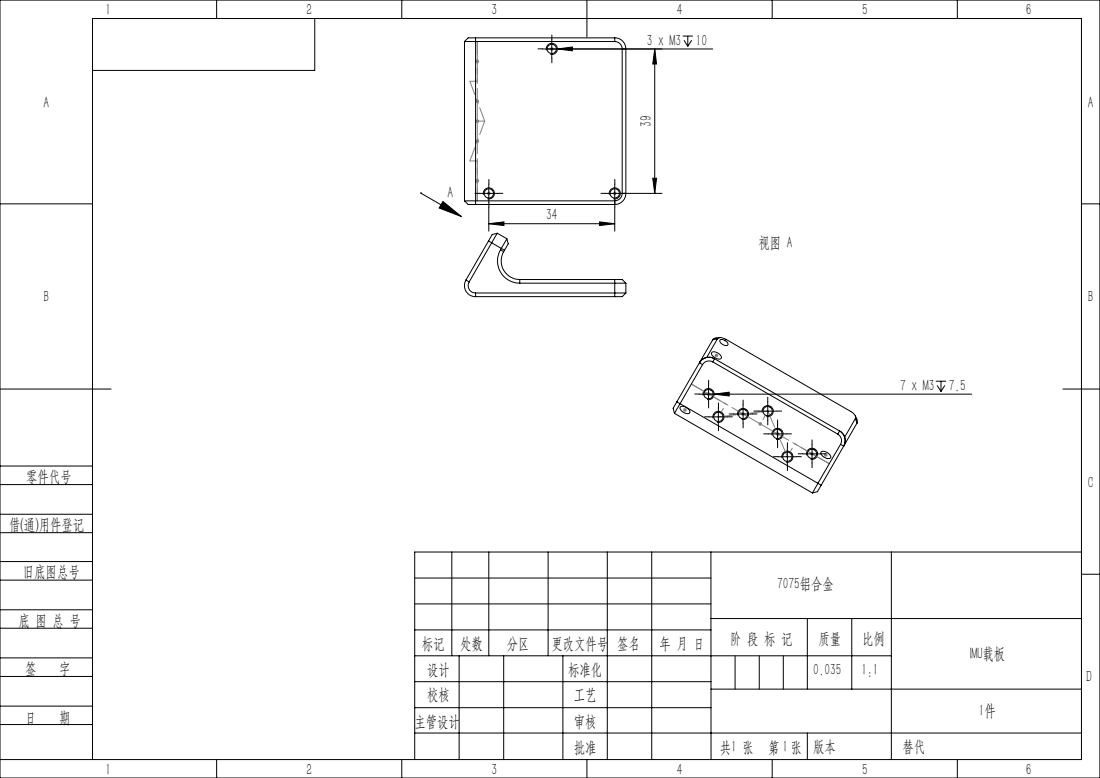
[picture p92: page 1]

7075铝合金

阶 段 标 记 | 质量 | 比例 | IMU载板

标记 | 处数 | 分区 | 更改文件号 | 签名 | 年 月 日
