Roboparty/roboto_origin/modules/Atom01_hardware/atom01_mechnaic/atom_wire/wire/ref.pdf

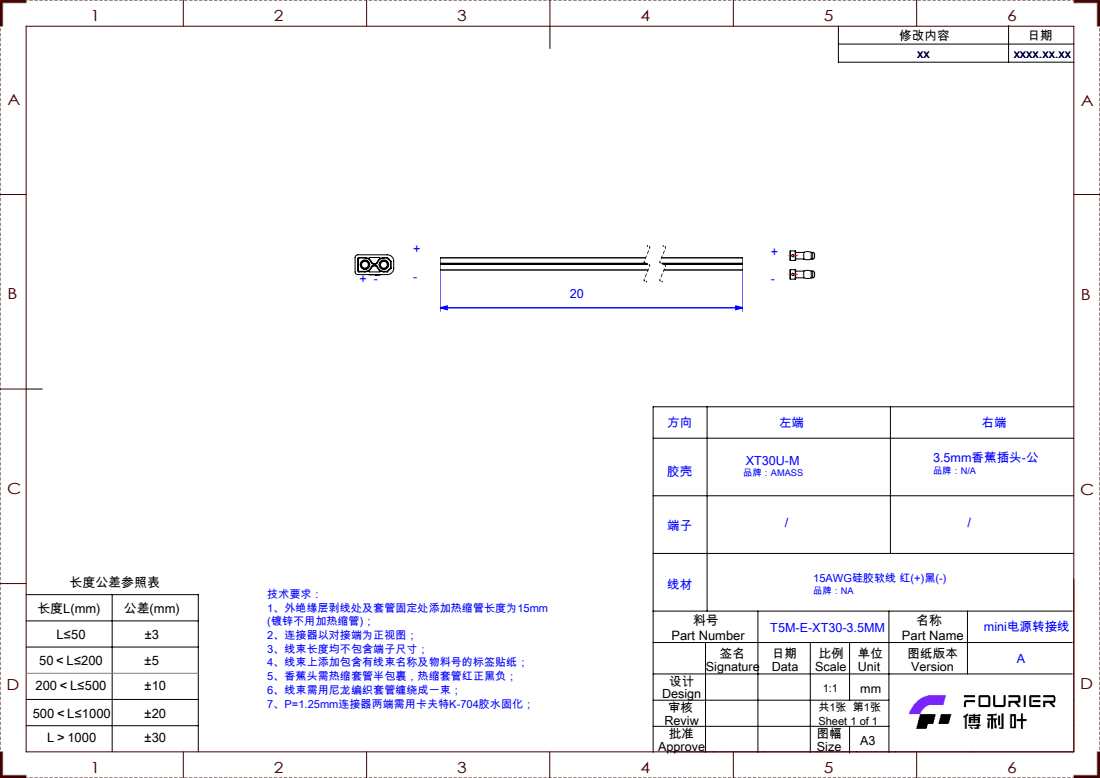
[picture p93: page 1]
共1张 第1张 Sheet 1 of 1

修改内容 | 日期
xx xx | xxxx.xx.xx

胶壳 | XT30U-M 品牌：AMASS | 3.5mm香蕉插头-公 品牌：N/A

线材 | 15AWG硅胶软线 红(+)黑(-) 品牌：NA

长度L(mm) | 公差(mm)
L≤50 | ±3
50＜L≤200 | ±5

料号 Part Number | T5M-E-XT30-3.5MM | 名称 Part Name | mini电源转接线

签名 Signature | 日期 Data | 比例 Scale | 单位 Unit | 图纸版本 Version | A
