Roboparty/roboto_origin/modules/Atom01_hardware/atom01_mechnaic/atom_wire/wire/wire02.pdf

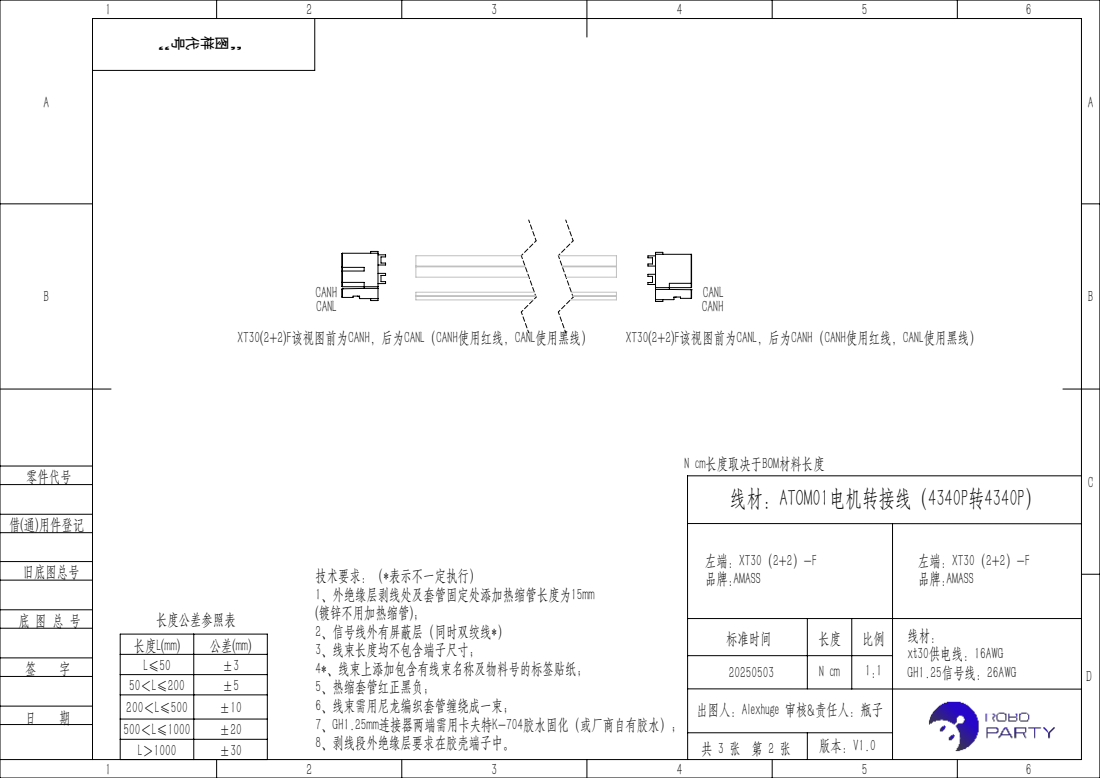
[picture p95: page 1]
N cm长度取决于BOM材料长度

XT30(2+2)F该视图前为CANH，后为CANL（CANH使用红线，CANL使用黑线）

XT30(2+2)F该视图前为CANL，后为CANH（CANH使用红线，CANL使用黑线）

左端：XT30（2+2）-F 品牌:AMASS | 左端：XT30（2+2）-F 品牌:AMASS

标准时间 | 长度 | 比例 | 线材： xt30供电线：16AWG GH1.25信号线：26AWG

长度L(mm) | 公差(mm)

50＜L≤200 | ±5
200＜L≤500 | ±10
500＜L≤1000 | ±20
L＞1000 | ±30

出图人：Alexhuge 审核&责任人：瓶子
