Roboparty/roboto_origin/modules/Atom01_hardware/atom01_mechnaic/Atom01_battery/battery.pdf

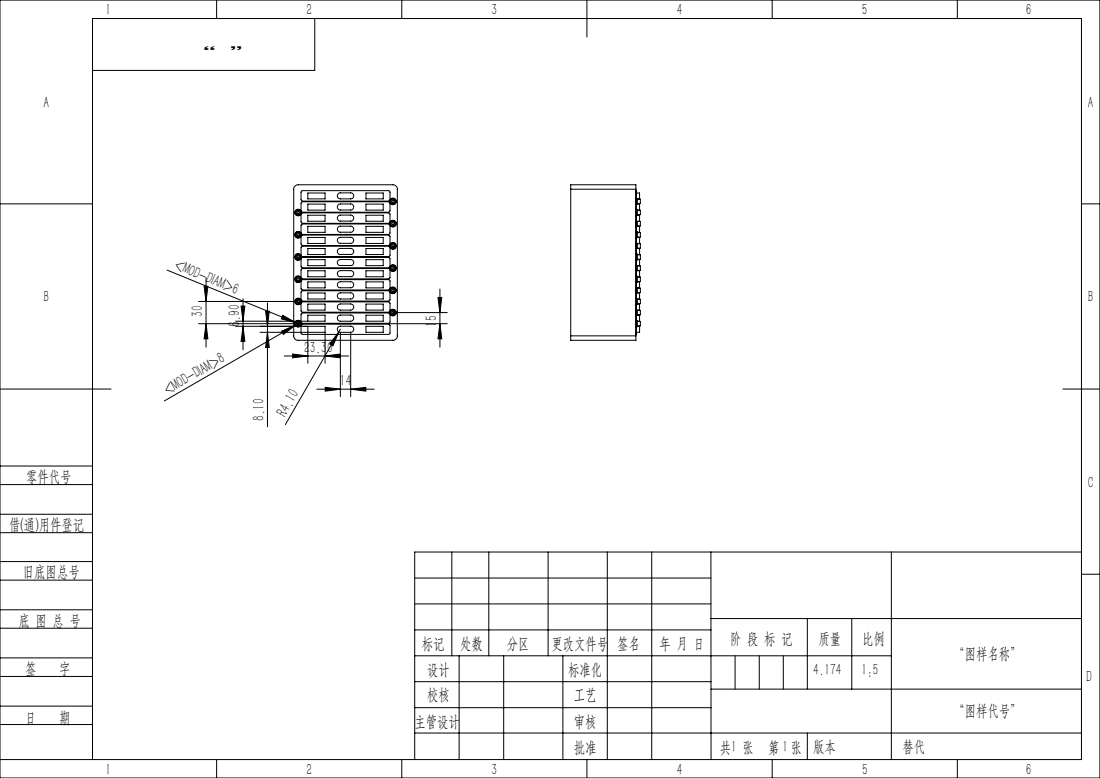
[picture p96: page 1]
<MOD-DIAM>8 30

阶 段 标 记 | 质量 | 比例 | “图样名称”

标记 | 处数 | 分区 | 更改文件号 | 签名 | 年 月 日

“图样代号”
