Roboparty/roboto_origin/modules/Atom01_hardware/atom01_mechnaic/atom-bom/图纸&STEP模型/20cm脚.pdf

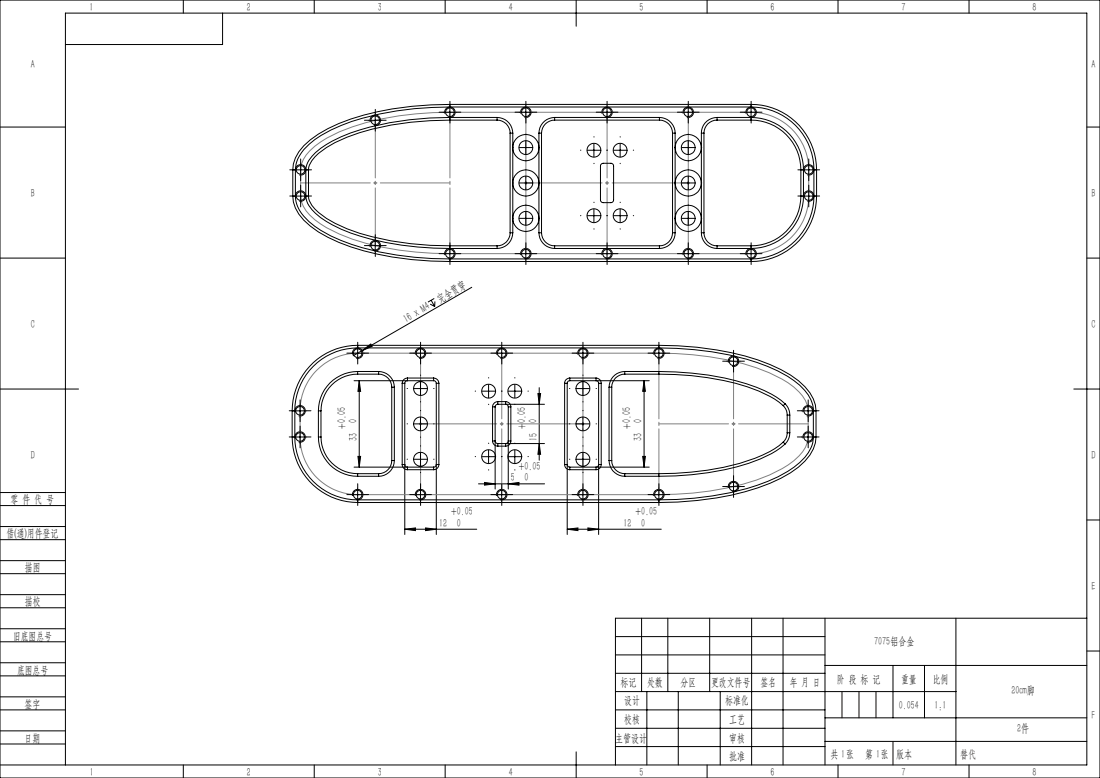
[picture p97: page 1]
16 x M4 完全贯穿

7075铝合金

阶 段 标 记 | 重量 | 比例 | 20cm脚

标记 | 处数 | 分区 | 更改文件号 | 签名 | 年 月 日
设计 | | | 标准化 | | | | | 0.054 | 1:1
校核 | | | 工艺
主管设计 | | | 审核
