Roboparty/roboto_origin/modules/Atom01_hardware/atom01_mechnaic/atom-bom/图纸&STEP模型/短连杆.pdf

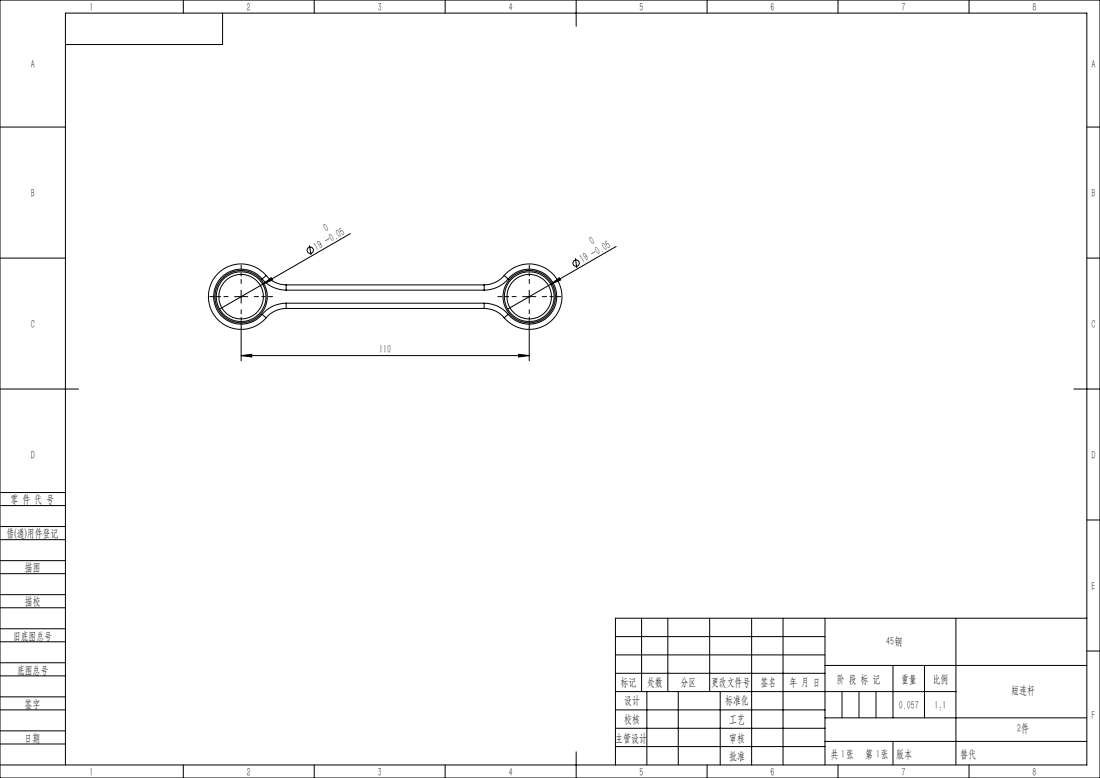
[picture p103: page 1]

阶 段 标 记 | 重量 | 比例 | 短连杆

标记 | 处数 | 分区 | 更改文件号 | 签名 | 年 月 日
设计 | | | 标准化 | | | | | 0.057 | 1:1
校核 | | | 工艺
主管设计 | | | 审核
