Roboparty/roboto_origin/modules/Atom01_hardware/atom01_mechnaic/atom-bom/图纸&STEP模型/肩膀.pdf

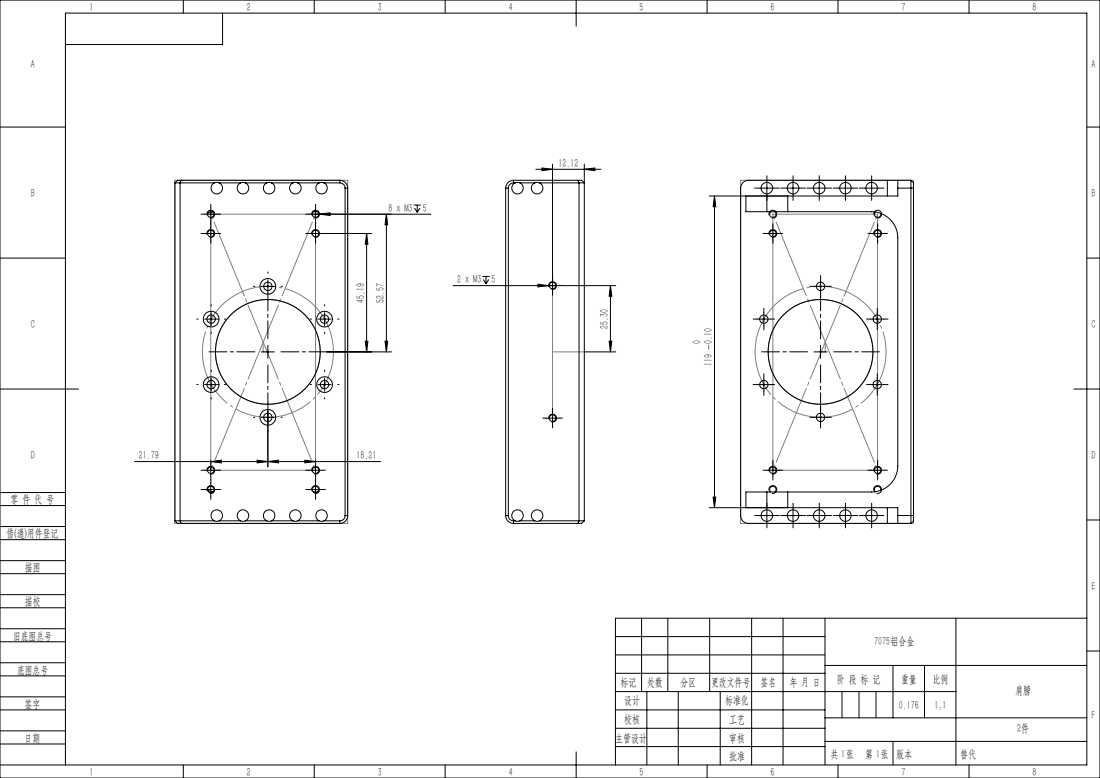
[picture p104: page 1]

7075铝合金

标记 | 处数 | 分区 | 更改文件号 | 签名 | 年 月 日
设计 | | | 标准化 | | | | | 0.176 | 1:1
校核 | | | 工艺
主管设计 | | | 审核
