Roboparty/roboto_origin/modules/Atom01_hardware/atom01_mechnaic/atom-bom/图纸&STEP模型/腰部支撑.pdf

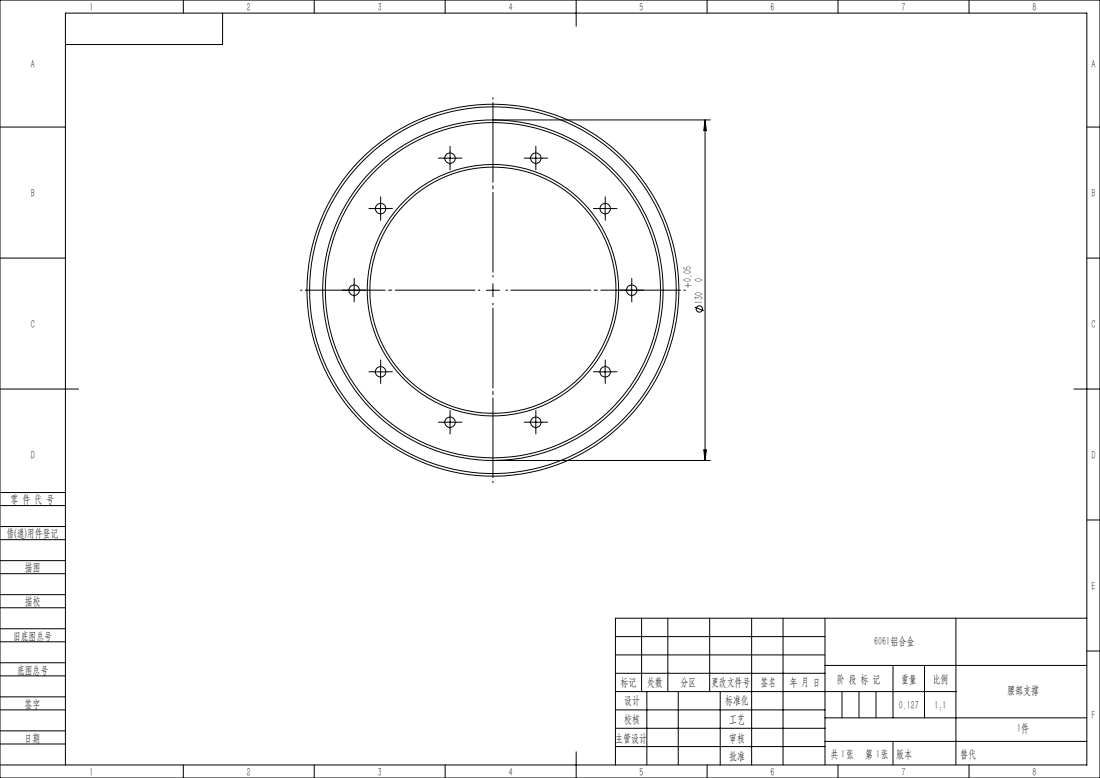
[picture p109: page 1]

6061铝合金

阶 段 标 记 | 重量 | 比例 | 腰部支撑

标记 | 处数 | 分区 | 更改文件号 | 签名 | 年 月 日
设计 | | | 标准化 | | | | | 0.127 | 1:1
校核 | | | 工艺
主管设计 | | | 审核
