Roboparty/roboto_origin/modules/Atom01_hardware/atom01_mechnaic/atom-bom/图纸&STEP模型/限位销.pdf

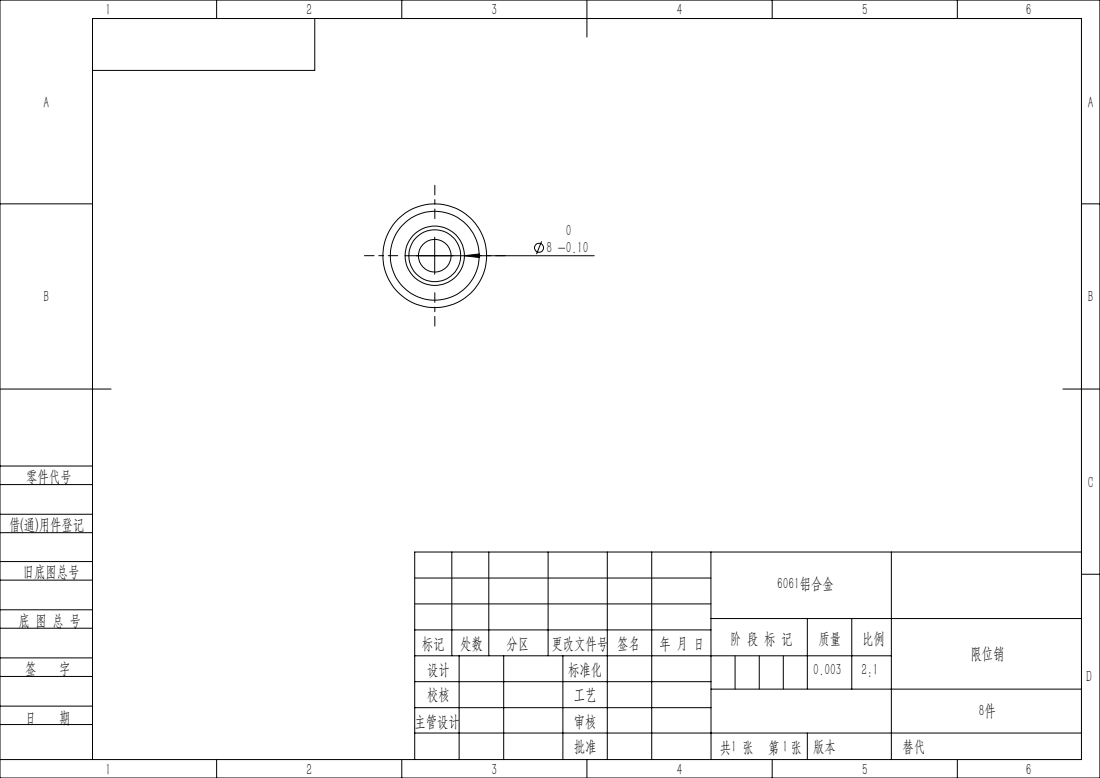
[picture p114: page 1]

6061铝合金

阶 段 标 记 | 质量 | 比例 | 限位销

标记 | 处数 | 分区 | 更改文件号 | 签名 | 年 月 日
