Roboparty/roboto_origin/(commit log)

2025-08-06 add limit effort and velocity
2025-08-16 update assets
    [atom01.xml]
2025-08-19 update stl
    [base_link.STL, left_ankle_pitch_link.STL, left_ankle_roll_link.STL, left_arm_pitch_link.STL, left_arm_roll_link.STL, left_arm_yaw_link.STL, left_elbow_pitch_link.STL, left_elbow_yaw_link.STL]
2025-08-19 update mjcf
    [atom01.xml]
2025-09-06 add interrupt
2025-09-06 interrupt sim2sim
2025-09-12 fix interrupt
2025-09-24 update interrupt
2025-09-24 fix interrupt reward
2025-10-22 two stage
2025-12-15 update xml
    [atom01_terrain.xml]
2025-12-26 attn_enc one stage training
2025-12-31 fix: 修复gif排列
2025-12-31 doc: add 中文
2026-01-05 refactor: rename atom01_urdf to atom01_description
    - Rename modules/atom01_urdf to modules/atom01_description
    - Update GitHub link in Readme.md to point to new repository
    - All files and history preserved via git mv
    [atom01.urdf, atom01.xml, atom01_terrain.xml, base_link.STL, left_ankle_pitch_link.STL, left_ankle_roll_link.STL, left_arm_pitch_link.STL, left_arm_roll_link.STL]
2026-01-06 doc: update bom
    [Internal Roboto D-BOM.xlsx]
2026-01-07 feat: 添加跑步训练代码开源
2026-01-11 chore: 将子模块转换为普通文件，生成完整快照
    - 删除子模块的 .git 目录，使其成为普通文件
    - 所有子模块代码现在直接包含在主仓库中
    - 用户克隆后无需任何初始化操作
    - 包含 157 个新文件（子模块源代码）
    子模块列表：
    - modules/atom01_deploy/inference
    - modules/atom01_deploy/motors
    - modules/atom01_deploy/imu
    - modules/atom01_deploy/create_ap
    - modules/atom01_train/rsl_rl
    [motors.yaml]
2026-01-30 Squashed 'modules/atom01_deploy/src/imu/' changes from d462911..5444bc1
    5444bc1 update priority
    git-subtree-dir: modules/atom01_deploy/src/imu
    git-subtree-split: 5444bc17e0e8f652b7e7eb8f6fb4865d28679bdd
2026-01-30 删除 atom01_description 的 gitlink 引用
2026-01-30 Squashed 'modules/atom01_train/robolab/data/robots/roboparty/atom01/' content from commit 9213a5e
    git-subtree-dir: modules/atom01_train/robolab/data/robots/roboparty/atom01
    git-subtree-split: 9213a5ed0bf5bd8b74509e33ce18dee557991691
    [atom01.urdf, atom01.xml, atom01_terrain.xml, base_link.STL, left_ankle_pitch_link.STL, left_ankle_roll_link.STL, left_arm_pitch_link.STL, left_arm_roll_link.STL]
