Roboparty/roboto_origin/(notices)

Notices in the files:
modules/atom01_train/README_CN.md:
License: BSD-3
README.md:
License: GPL v3
